dschnitkey/Fluorostat_Codes/fluorostat Illustrations/Images/Optics.jpg

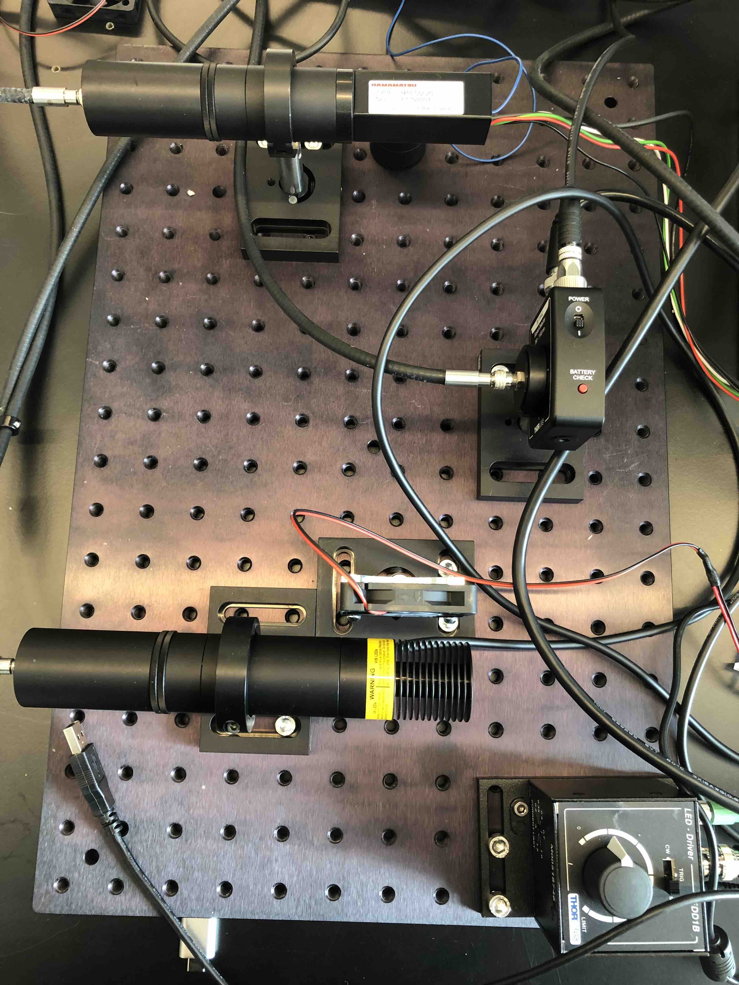
fluorostat Illustrations/Images/Optics.jpg
