dschnitkey/Fluorostat_Codes/fluorostat Illustrations/Images/fsat_evap - 1.jpg

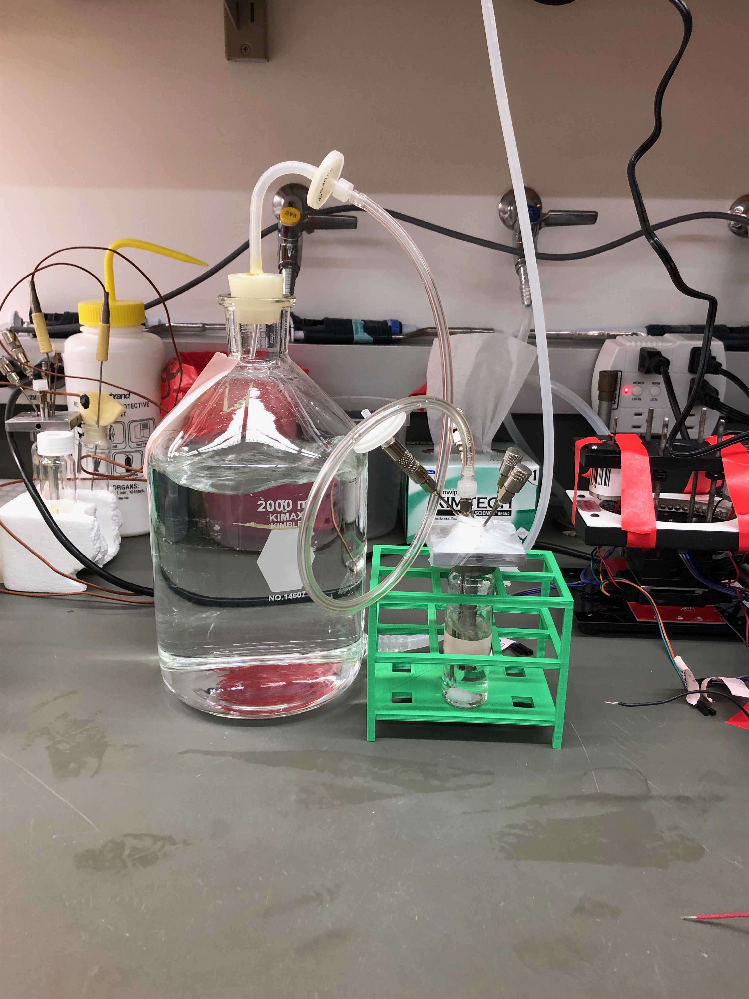
fluorostat Illustrations/Images/fsat_evap - 1.jpg
