dschnitkey/Fluorostat_Codes/Fluorostat Construction/spetra/Figures/All_Spectra_Coming_From_Sample.png

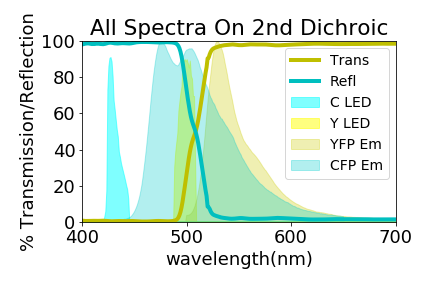
Fluorostat Construction/spetra/Figures/All_Spectra_Coming_From_Sample.png
