dschnitkey/Fluorostat_Codes/Fluorostat Construction/spetra/Figures/CFP Spectra and filters.png

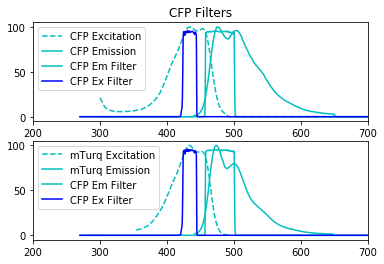
Fluorostat Construction/spetra/Figures/CFP Spectra and filters.png
