dschnitkey/Fluorostat_Codes/Fluorostat Construction/spetra/Figures/Cyan_LED_Spectrum.png

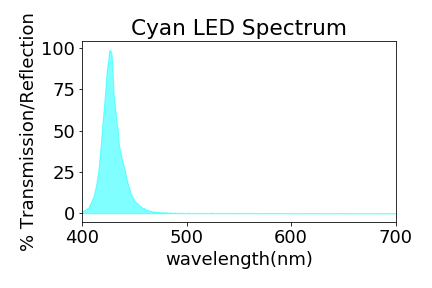
Fluorostat Construction/spetra/Figures/Cyan_LED_Spectrum.png
