dschnitkey/Fluorostat_Codes/Fluorostat Construction/spetra/Figures/Specific_Excitation.png

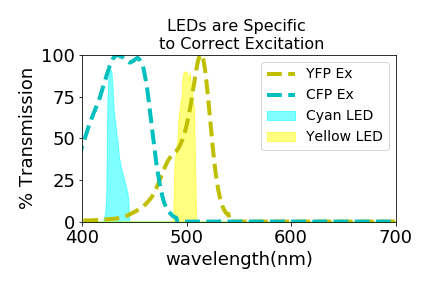
Fluorostat Construction/spetra/Figures/Specific_Excitation.png
