dschnitkey/Fluorostat_Codes/Fluorostat Construction/spetra/Figures/Spectra_Reaching_Sample.png

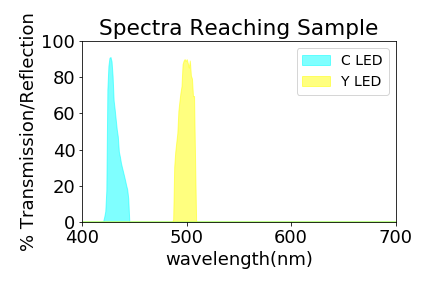
Fluorostat Construction/spetra/Figures/Spectra_Reaching_Sample.png
