dschnitkey/Fluorostat_Codes/Fluorostat Construction/spetra/Figures/spectraviewer_graph (3).png

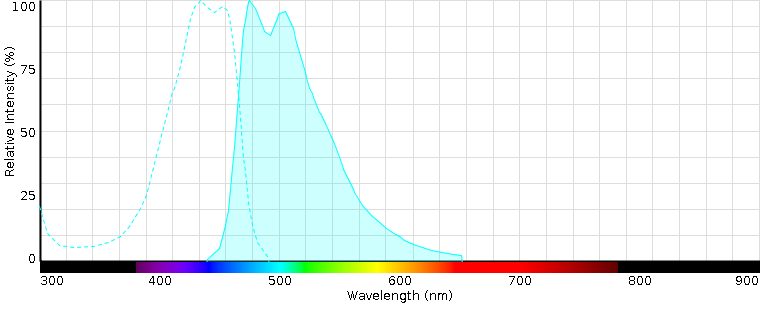
Fluorostat Construction/spetra/Figures/spectraviewer_graph (3).png
