dschnitkey/Fluorostat_Codes/Fluorostat Construction/spetra/Figures/Yellow_LED_Spectrum.png

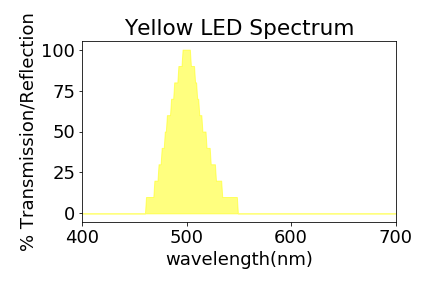
Fluorostat Construction/spetra/Figures/Yellow_LED_Spectrum.png
