dschnitkey/Fluorostat_Codes/Fluorostat Construction/spetra/Figures/YFP spectra and filters.png

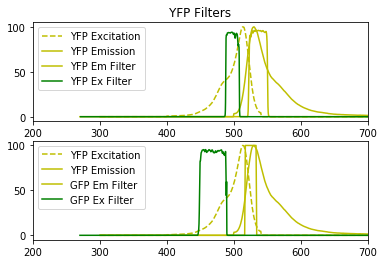
Fluorostat Construction/spetra/Figures/YFP spectra and filters.png
