dschnitkey/Fluorostat_Codes/fluorostat Illustrations/cyanomod_fluorostat_schematic.png

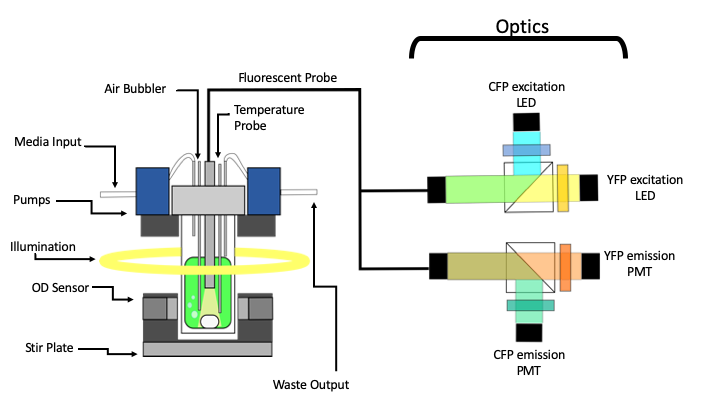
fluorostat Illustrations/cyanomod_fluorostat_schematic.png
