dschnitkey/Fluorostat_Codes/fluorostat Illustrations/fluorostat.png

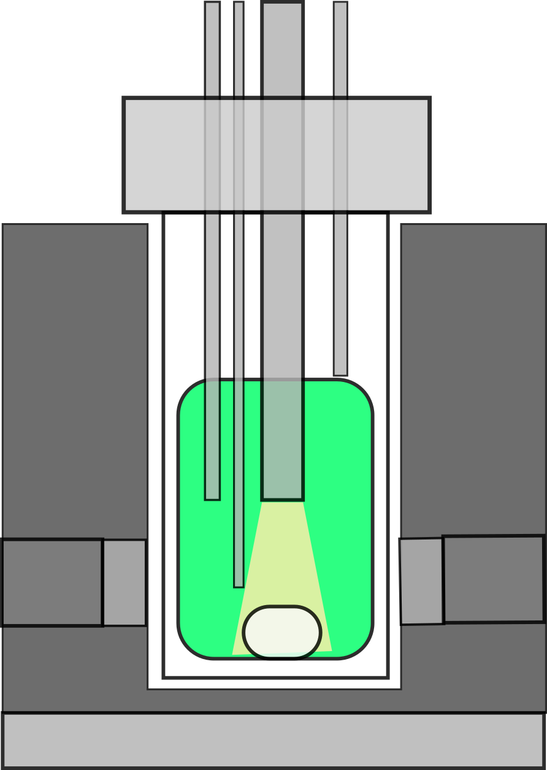
fluorostat Illustrations/fluorostat.png
