dschnitkey/Fluorostat_Codes/fluorostat Illustrations/fluorostat_aeration.png

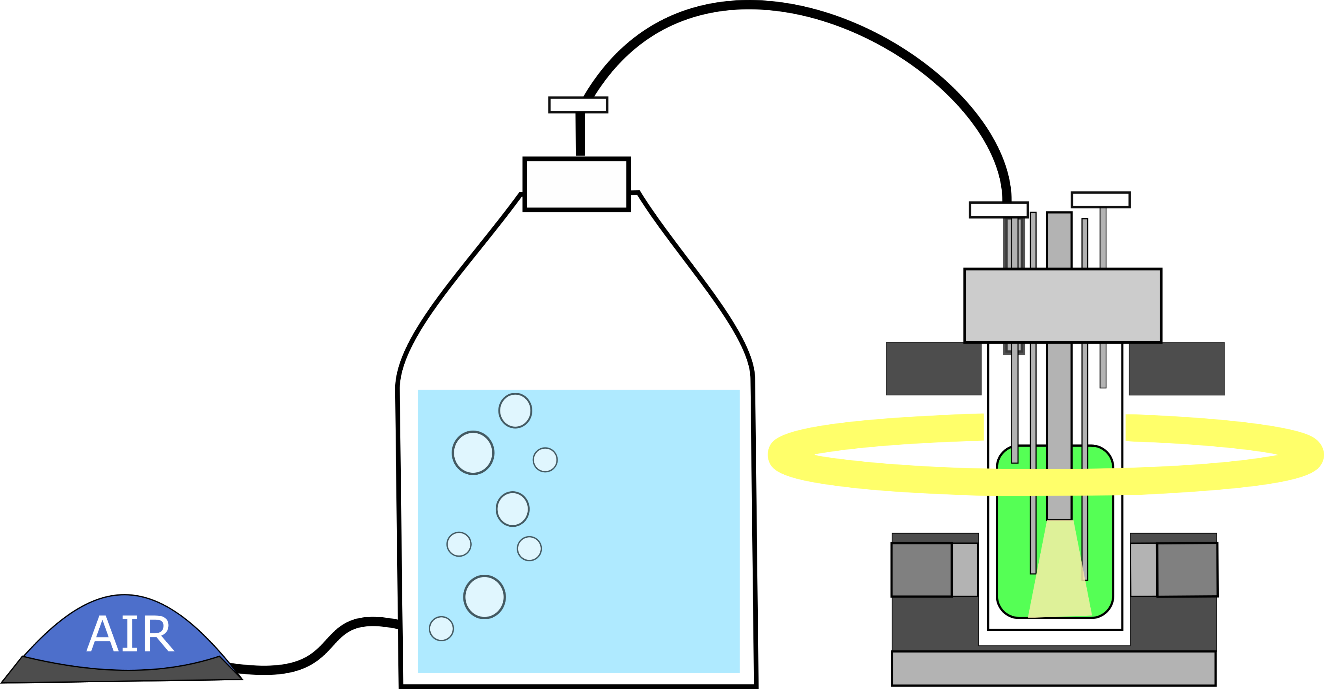
fluorostat Illustrations/fluorostat_aeration.png
