dschnitkey/Fluorostat_Codes/fluorostat Illustrations/fluorostat_base.jpg.png

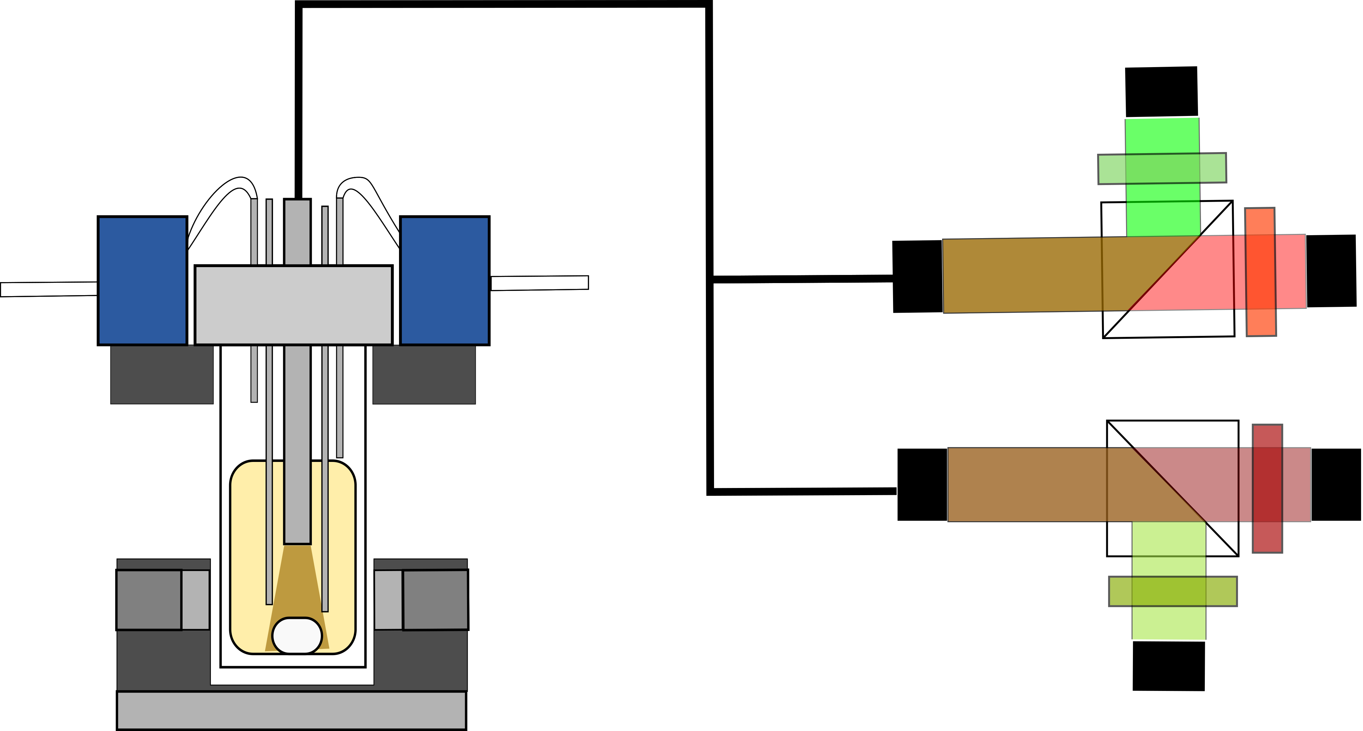
fluorostat Illustrations/fluorostat_base.jpg.png
