dschnitkey/Fluorostat_Codes/fluorostat Illustrations/fluorostat_foamcap_probe.png

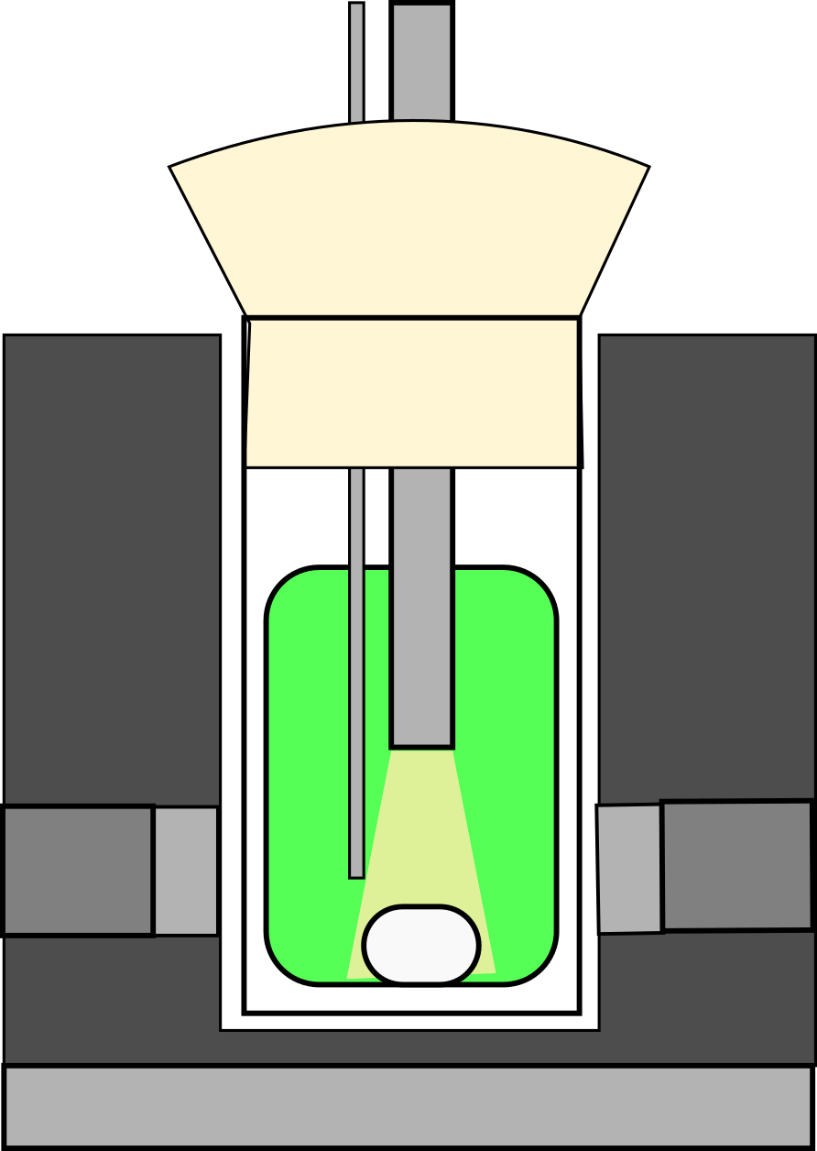
fluorostat Illustrations/fluorostat_foamcap_probe.png
