dschnitkey/Fluorostat_Codes/fluorostat Illustrations/fluorostat_foamcap_ringlight.png

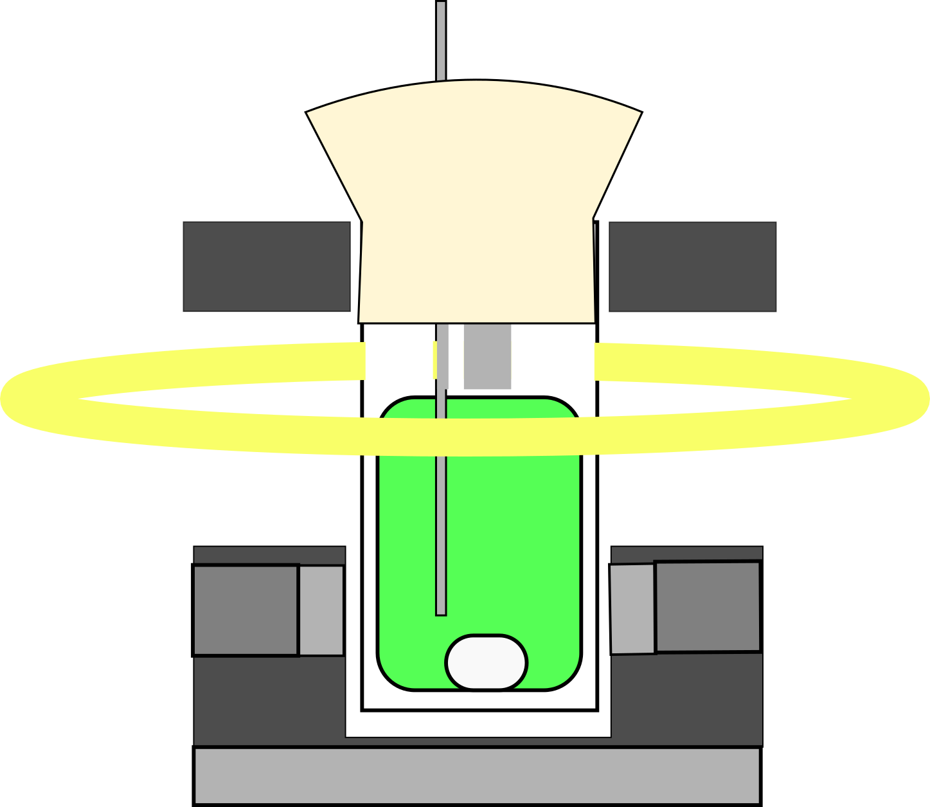
fluorostat Illustrations/fluorostat_foamcap_ringlight.png
