dschnitkey/Fluorostat_Codes/fluorostat Illustrations/fluorostatdead.png

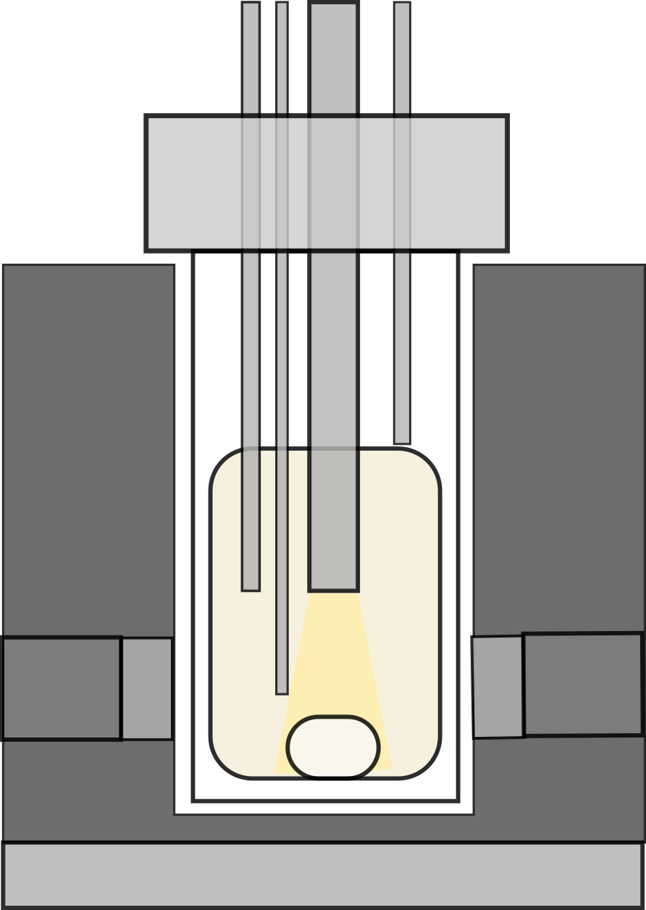
fluorostat Illustrations/fluorostatdead.png
