dschnitkey/Fluorostat_Codes/fluorostat Illustrations/fstat_air.png

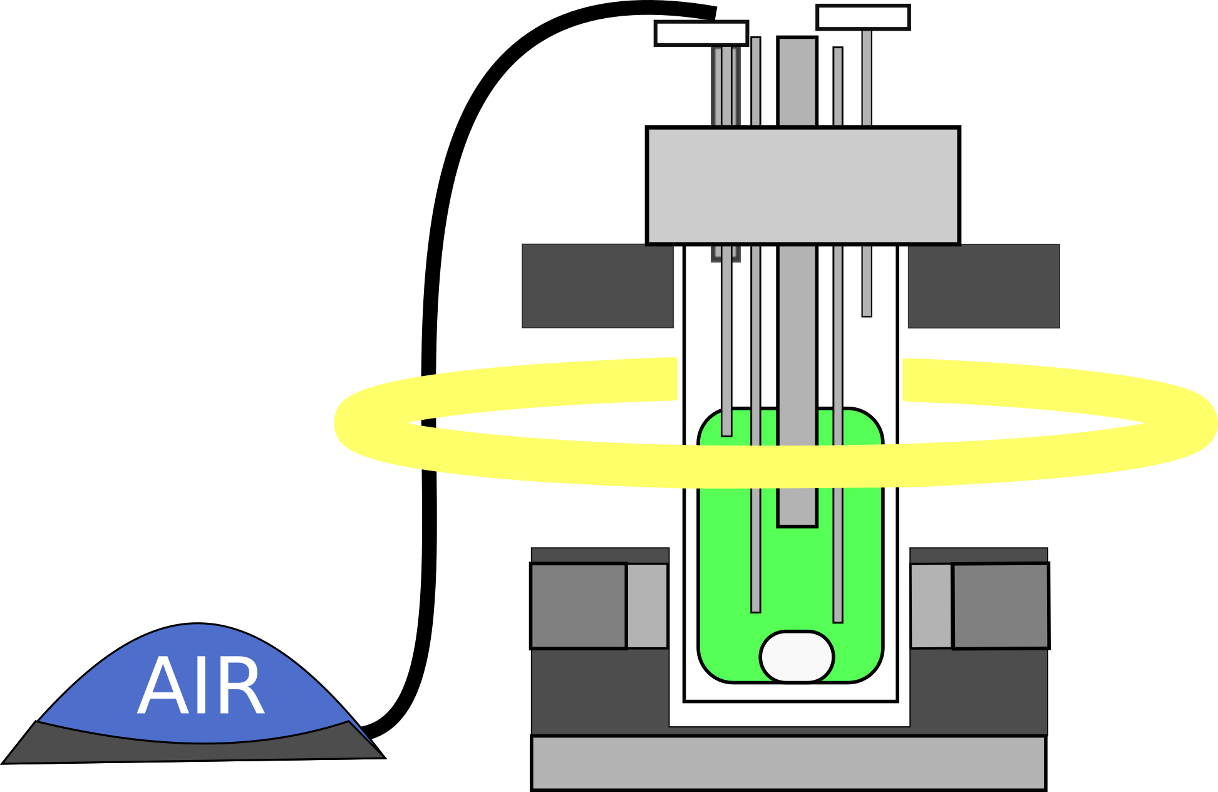
fluorostat Illustrations/fstat_air.png
