dschnitkey/Fluorostat_Codes/fluorostat Illustrations/Images/fsat_evap - 2.jpg

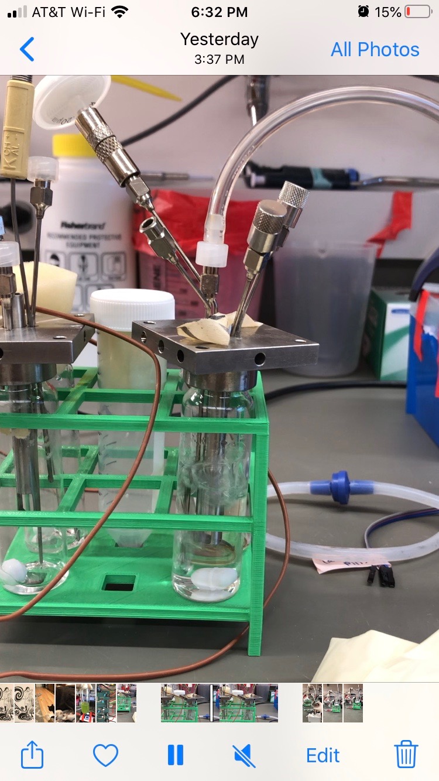
fluorostat Illustrations/Images/fsat_evap - 2.jpg
