dschnitkey/Fluorostat_Codes/fluorostat Illustrations/Images/fsat_evap - 3.jpg

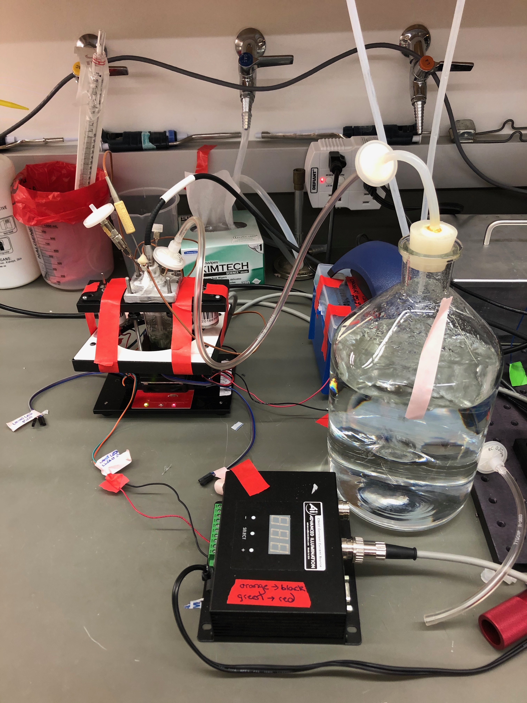
fluorostat Illustrations/Images/fsat_evap - 3.jpg
