dschnitkey/Fluorostat_Codes/fluorostat Illustrations/Images/Plugs.jpg

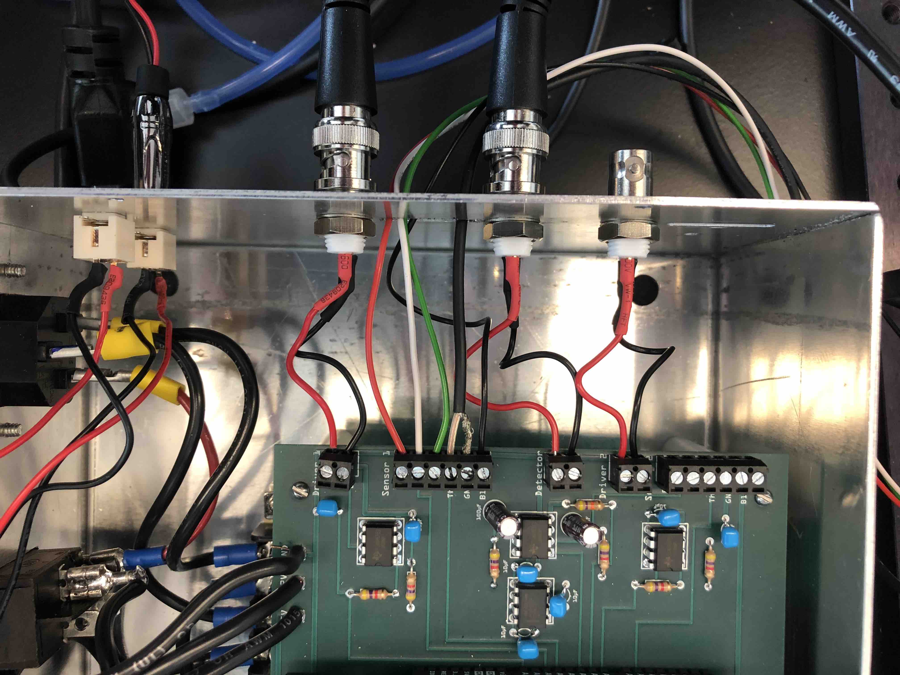
fluorostat Illustrations/Images/Plugs.jpg
