dschnitkey/Fluorostat_Codes/Fluorostat Construction/Fluorostat PCB Plans/partslist.xlsx

Amount | Part Type | Properties | Link | Unit Price | Total
2 | Diode | variant 1n4148; package diode-1n4148 | https://www.digikey.com/product-detail/en/on-semiconductor/1N914ATR/1N914ACT-ND/1626125
7 | 390Ω Resistor | bands 4; package THT; tolerance ±5%; pin spacing 400 mil; resistance 390Ω | https://www.digikey.com/product-detail/en/stackpole-electronics-inc/CF14JT390R/CF14JT390RCT-ND/1830340
7 | Ceramic Capacitor | package 200 mil [THT, multilayer]; capacitance 10µF; voltage 6.3V | https://www.digikey.com/product-detail/en/tdk-corporation/FK28X5R0J106MR000/445-FK28X5R0J106MR000-ND/2815522
3 | Generic female header - 1 pins | row single; hole size 2.2mm,0.508mm; form ♀ (female); pins 1; package THT; pin spacing 0.15in (3.81mm) | https://www.digikey.com/product-detail/en/sullins-connector-solutions/PPTC021LFBN-RC/S7000-ND/810142
6 | 4.7kΩ Resistor | bands 4; package THT; tolerance ±5%; pin spacing 400 mil; resistance 4.7kΩ | https://www.digikey.com/product-detail/en/stackpole-electronics-inc/CF14JT4K70/CF14JT4K70CT-ND/1830366 | 1.62/100 | 1.62
1 | 47kΩ Resistor | bands 4; package THT; tolerance ±5%; pin spacing 400 mil; resistance 47kΩ | https://www.digikey.com/product-detail/en/stackpole-electronics-inc/CFM14JT47K0/S47KQCT-ND/2617761 | .75/25 | 0.75
1 | Arduino Mega 2560 (Rev3) | type Arduino MEGA 2560 (Rev3) | https://www.digikey.com/products/en/development-boards-kits-programmers/evaluation-boards-embedded-mcu-dsp/786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 | 38.5 | 38.5
2 | Electrolytic Capacitor | package 100 mil [THT, electrolytic]; capacitance 100µF; voltage 6.3V | https://www.digikey.com/product-detail/en/panasonic-electronic-components/ECE-A0JKA101I/P19574CT-ND/6109472 | 1.53/10 | 1.53
4 | IC | hole size 1.0mm,0.508mm; pins 8; true; chip label IC; package DIP (Dual Inline) [THT]; pin spacing 300mil | https://www.digikey.com/product-detail/en/texas-instruments/LM358P/296-1395-5-ND/277042 | 6.45/25 | 6.45
3 | Screw terminal - 2 pins | hole size 1.1mm,0.508mm; pins 2; package THT; pin spacing 0.137in (3.5mm) | https://www.digikey.com/product-detail/en/phoenix-contact/1984617/277-1721-ND/950849 | 4.59/10 | 4.59
1 | Screw terminal - 4 pins | hole size 1.1mm,0.508mm; pins 4; package THT; pin spacing 0.137in (3.5mm) | https://www.digikey.com/product-detail/en/phoenix-contact/1985218/277-1624-ND/568661 | 5.55/10 | 5.55
15 | Generic female header - 1 pins | row single; hole size 1.0mm,0.4mm; form ♀ (female); pins 1; package THT; pin spacing 0.1in (2.54mm) | https://www.digikey.com/product-detail/en/sullins-connector-solutions/PPTC021LFBN-RC/S7000-ND/810142
1 | Generic female header - 2 pins | row single; hole size 1.0mm,0.4mm; form ♀ (female); pins 2; package THT; pin spacing 0.15in (3.81mm) | https://www.digikey.com/product-detail/en/sullins-connector-solutions/PPTC021LFBN-RC/S7000-ND/810142
1 | Generic female header - 6 pins | row single; hole size 1.0mm,0.4mm; form ♀ (female); pins 6; package THT; pin spacing 0.1in (2.54mm) | https://www.digikey.com/product-detail/en/sullins-connector-solutions/PPPC061LGBN-RC/S5481-ND/775939
6 | NPN-Transistor | type NPN (ECB); package TO92 [THT] | https://www.digikey.com/product-detail/en/on-semiconductor/2N5551BU/2N5551BU-ND/973957 | 2.28/10 | 2.28
2 | Screw terminal - 6 pins | hole size 1.1mm,0.508mm; pins 6; package THT; pin spacing 0.137in (3.5mm) | https://www.digikey.com/product-detail/en/on-shore-technology-inc/OSTTE060161/ED2639-ND/614588 | 10.68/10 | 10.68
 |  |  |  |  | 71.95
