dschnitkey/Fluorostat_Codes/Fluorostat Construction/Original Parts Lists/parts-list-fluorostat.xlsx

Sheet: Base Fluorostat
Part | Number | Source | Notes
For eGFP measurement
25mm dia gfp signal filter 525/15 | 1 | https://www.edmundoptics.com/p/525nm-cwl-25mm-dia-15nm-bandwidth-od-6-fluorescence-filter/28790/
25mm dia gfp excite filter 469/35 | 1 | https://www.thorlabs.com/thorproduct.cfm?partnumber=MF469-35
Excitation LED (for eGFP) | 1 | https://www.thorlabs.com/thorproduct.cfm?partnumber=M470L3
For mKATE measuremnt
25mm dia mkate signal filter 640/14 | 1 | https://www.edmundoptics.com/p/640nm-cwl-25mm-dia-14nm-bandwidth-od-6-fluorescence-filter/29399/
25mm dia mkate excite filter 586/20 | 1 | https://www.edmundoptics.com/p/586nm-cwl-25mm-dia-20nm-bandwidth-od-6-fluorescence-filter/27209/
Excitation LED (for mKate) | 1 | https://www.thorlabs.com/thorproduct.cfm?partnumber=M590L4
Sample Holder
photospectrometers | 2
Fan | 2 | https://www.digikey.ca/scripts/DkSearch/dksus.dll?Detail&itemSeq=243382999&uq=636457645476840310
Magnet | 4 | https://www.digikey.ca/product-detail/en/radial-magnet-inc/8195/469-1005-ND/555329
OD Amber LED | 4 | https://www.digikey.ca/products/en/optoelectronics/infrared-uv-visible-emitters/94?k=1125%201307%20ND
OD Sensor | 8 | https://www.adafruit.com/product/2748
heater | 2 | https://www.adafruit.com/product/1331
Pumps | 4 | https://www.adafruit.com/product/1150
Pump Tubings |  | https://www.coleparmer.ca/i/mn/0641163 | 3/32"ID x 5/32"OD | 25ml/19sec
Pump connectors | 4 | https://www.mcmaster.com/#5121k231/=1a3k74d | 1/8" to 3/32"
Media tubing |  | https://www.mcmaster.com/#5041k653/=1cqq3hs
Needle caps plastic |  | https://www.coleparmer.com/i/cole-parmer-animal-free-male-luer-lock-plug-pp-25-pk/3080030?pubid=SI | Male Luer Lock Plug
Needle caps stainless steel |  | https://www.mcmaster.com/#5194k37/=1cromkj
Thumb Nut | 4 | https://www.mcmaster.com/#93886a120/=1agy9nn
StirBar | 4 | https://www.uoftmedstore.com/item_detail.sz?id=553 | VWR, 1/2"x5/16"
2" 16G Needles | 20 | https://www.mcmaster.com/#6710a23/=1ccc100
4" 16G Needles for pump | 20 | https://www.mcmaster.com/#6710a43/=1ccc162
20G 4" Sampling needels | 20 | https://www.mcmaster.com/#6710a45/=1cron9z
2" 10G Needles
class bottles | 2
Optics:
HAMAMTSU MicroPMT | 1 | https://www.hamamatsu.com/us/en/product/type/H10722-20/index.html | A9865
PMT to cmount adaptor | 1 | https://www.hamamatsu.com/us/en/product/type/A9865/index.html | RP26
Fiber Optic Reflection/Backscatter Probe Bundles with Reference Leg | 1 | https://www.thorlabs.com/thorproduct.cfm?partnumber=RP26 | 470L3
Excitation LED (for eGFP) | 1 | https://www.thorlabs.com/thorproduct.cfm?partnumber=M470L3 | LEDD1B
Excitation LED Driver cube | 1 | https://www.thorlabs.com/thorproduct.cfm?partnumber=LEDD1B | KPS101
powersupply for LED driver cube | 1 | https://www.thorlabs.com/thorproduct.cfm?partnumber=KPS101 | ET36A2
DET36A2 excitation reference detector (https://www.thorlabs.com/images/xlarge/TTN134189-xl.jpg) | 1 | https://www.thorlabs.com/thorproduct.cfm?partnumber=DET36A2 | DET2B
DET Power Adapter & Power Supply Bundle | 1 | https://www.thorlabs.com/thorproduct.cfm?partnumber=DET2B | SM1SMA
SMA Fiber Adapter for DET36A2 | 1 | https://www.thorlabs.com/thorproduct.cfm?partnumber=SM1SMA | Ø1"
SM1RR Retaining Ring For stackable lens mount 0.08 thick | 4 | https://www.thorlabs.com/thorproduct.cfm?partnumber=SM1RR | ACL2520U-A
ACL2520U-A - Aspheric Condenser Lens, Ø25 mm, f=20.1 mm, NA=0.60 ARC: 350-700 nm | 4 | https://www.thorlabs.com/thorproduct.cfm?partnumber=ACL2520U-A | SM1M20
SM1 Lens Tube Without External Threads, 2" Long | 2 | https://www.thorlabs.com/thorproduct.cfm?partnumber=SM1M20 | SM1T2
SM1 Coupler, External Threads, 0.5" Long | 2 | https://www.thorlabs.com/thorproduct.cfm?partnumber=SM1T2 | SM1L20
SM1 Lens Tube, 2.00" Thread Depth | 1 | https://www.thorlabs.com/thorproduct.cfm?partnumber=SM1L20 | SM1L05 | ,
SM1 Lens Tube, 0.50" Thread Depth | 2 | https://www.thorlabs.com/thorproduct.cfm?partnumber=SM1L05 | SM1SMA
SMA Fiber Adapter Plate with External SM1 Threads | 2 | https://www.thorlabs.com/thorproduct.cfm?partnumber=SM1SMA | SM1L15
SM1 Lens Tube, 1.50" Thread Depth | 1 | https://www.thorlabs.com/thorproduct.cfm?partnumber=SM1L15 | BA2E
Flexure Clamping Base / Post Mount, Ø1/2" Double Bore, 2.00" x 3.00" x 0.48" | 6 | https://www.thorlabs.com/thorproduct.cfm?partnumber=BA2E | SM1TC
SM1TC - Ø1.20" Clamp for SM1 Lens Tubes and C-Mount Extension Tubes | 4 | https://www.thorlabs.com/thorproduct.cfm?partnumber=SM1TC | TR50/M
Ø12.7 mm Optical Post, SS, M4 Setscrew, M6 Tap, L = 50 mm | 6 | https://www.thorlabs.com/thorproduct.cfm?partnumber=TR50/M | SH6MS10
M6 x 1.0 Stainless Steel Cap Screw, 10 mm Long, Pack of 25 | 1 | https://www.thorlabs.com/thorproduct.cfm?partnumber=SH6MS10 | SM1RRC
SM1RRC - Extra-Thick SM1 (1.035"-40) Threaded Retaining Ring | 4 | https://www.thorlabs.com/thorproduct.cfm?partnumber=SM1RRC
Aluminium Breadboard, 300 mm x 450 mm x 12.7 mm, M6 taps | 1 | https://www.thorlabs.com/thorproduct.cfm?partnumber=MB3045/M

Sheet: Cyano Mods
Part | Number | Source | Part Number | Unit Price | Price
For YFP measurement
YFP Excitation Filter, CWL = 497 nm, BW = 16 nm | 1 | https://www.thorlabs.com/thorproduct.cfm?partnumber=MF497-16 | MF497-16 | $250.04 | $250.04
YFP Emission Filter, CWL = 535 nm BW = 22 nm | 1 | https://www.thorlabs.com/thorproduct.cfm?partnumber=MF535-22 | MF535-22 | $250.04 | $250.04
Excitation LED (for YFP) | 1 | https://www.thorlabs.com/thorproduct.cfm?partnumber=M505L4 | M505L4 | $287.86 | $287.86
 |  |  |  |  |  | Total Price
For CFP measurement |  |  |  |  |  | 2854.55
CFP Emission Filter, CWL = 479 nm, BW = 40 nm | 1 | https://www.thorlabs.com/thorproduct.cfm?partnumber=MF479-40 | MF479-40 | $250.04 | $250.04
CFP Excitation Filter, CWL = 434 nm, BW = 17 nm | 1 | https://www.thorlabs.com/thorproduct.cfm?partnumber=MF434-17 | MF434-17 | $250.04 | $250.04
Excitation LED (for CFP) | 1 | https://www.thorlabs.com/thorproduct.cfm?partnumber=M430L4 | M430L4 | $169.95 | $169.95
Dichroic
5 mm x 36 mm Longpass Dichroic Mirror, 505 nm | 1 | https://www.thorlabs.com/thorproduct.cfm?partnumber=DMLP505R | DMLP505R | $246.89 | $246.89
DMLP490R - 25 mm x 36 mm Longpass Dichroic Mirror, 490 nm Cut-On | 1 | https://www.thorlabs.com/thorproduct.cfm?partnumber=DMLP490R | DMLP490R | $246.89 | $246.89
Dichroic filter mount, 30 mm cage system | 2 | https://www.thorlabs.com/thorproduct.cfm?partnumber=CM1-DCH | CM1-DCH | $170.20 | $340.40
 | 2 | https://www.thorlabs.com/thorproduct.cfm?partnumber=SM1L03 | SM1L03 | $12.16 | $24.32
OD 700 parts
720 nm LED | 1 | https://www.digikey.com/products/en?WT.z_cid=sp_1125_buynow&site=us&mpart=MT5720-IR | 1125-1411-ND | $7.20 | $7.20
730 nm LED can top (Backup Option) | 0 | https://www.digikey.ca/product-detail/en/advanced-photonix/LS-0730-015/LS-0730-015-ND/9666161 | LS-0730-015-ND | $12.50 | $0.00
Illumination
Warm White LED | 1 | https://www.ledsupply.com/leds/5mm-led-warm-white-50-degree-viewing-angle | L1-0-WW5TH50-1 | $0.49 | $0.49
Circular Illumination Ring
Two Color Cage Set Up
Ø1" Retaining Rings and Spanner Wrenches | 1 | https://www.thorlabs.com/thorproduct.cfm?partnumber=SPW602 | SPW602 | $27.55 | $27.55
Cage Assembly Rod, 1/4" Long, Ø6 mm | 64 | https://www.thorlabs.com/thorproduct.cfm?partnumber=ER025 | ER025 | $5.05 | $323.20
Aspheric Condenser Lens | 6 | https://www.thorlabs.com/thorproduct.cfm?partnumber=ACL2520U-A | ACL2520U-A | $29.94 | $179.64

Sheet: Sheet1
Item # | Infoa | Nominal | Housing | LED Output Power | Bandwidth | Irradiance | Max Current | Forward | Viewing Angle | Recommended | Fluorophore
 |  | Wavelengthb,c | Typed | (Min / Typ.)b,e | (FWHM) | (Typ.)f | (CW) | Voltage (Typ.) | (Full Angle at Half Max) | Driver
M590L4 |  | 590 nm (Amber) |  | 230 mW / 300 mW | 15 nm | 6.0 µW/mm2 | 1000 mA | 2.5 V | 80° | DC2200, LEDD1B, DC4100h, or DC4104h | RFP
M470L4 |  | 470 nm (Blue) |  | 760 mW / 965 mW | 26 nm | 19.9 µW/mm2 | 1000 mA | 3.2 V | 80° | DC2200, LEDD1B, DC4100h, or DC4104h | GFP
M430L4 |  | 430 nm (Violet) |  | 490 mW / 600 mW | 15 nm | 35.3 µW/mm2 | 500 mA | 3.8 V | 22° | DC2200, LEDD1B, DC4100h, or DC4104h | CFP
M505L4 |  | 505 nm (Cyan) |  | 400 mW / 520 mW | 37 nm | 5.94 µW/mm2 | 1000 mA | 3.5 V | 130° | DC2200, LEDD1B, DC4100h, or DC4104h | YFP
