dschnitkey/Fluorostat_Codes/Fluorostat Construction/Original Parts Lists/CFP_YFP_Optics.xlsx

Part | Number | Source | Part Number | Unit Price | Price
For YFP measurement
YFP Excitation Filter, CWL = 497 nm, BW = 16 nm | 1 | https://www.thorlabs.com/thorproduct.cfm?partnumber=MF497-16 | MF497-16 | $250.04 | $250.04
YFP Emission Filter, CWL = 535 nm BW = 22 nm | 1 | https://www.thorlabs.com/thorproduct.cfm?partnumber=MF535-22 | MF535-22 | $250.04 | $250.04
Excitation LED (for YFP) | 1 | https://www.thorlabs.com/thorproduct.cfm?partnumber=M505L4 | M505L4 | $287.86 | $287.86
 |  |  |  |  |  | Total Price
For CFP measurement |  |  |  |  |  | 2747.48
CFP Emission Filter, CWL = 479 nm, BW = 40 nm | 1 | https://www.thorlabs.com/thorproduct.cfm?partnumber=MF479-40 | MF479-40 | $250.04 | $250.04
CFP Excitation Filter, CWL = 434 nm, BW = 17 nm | 1 | https://www.thorlabs.com/thorproduct.cfm?partnumber=MF434-17 | MF434-17 | $250.04 | $250.04
Excitation LED (for CFP) | 1 | https://www.thorlabs.com/thorproduct.cfm?partnumber=M430L4 | M430L4 | $169.95 | $169.95
Dichroic
5 mm x 36 mm Longpass Dichroic Mirror, 505 nm | 1 | https://www.thorlabs.com/thorproduct.cfm?partnumber=DMLP505R | DMLP505R | $246.89 | $246.89
DMLP490R - 25 mm x 36 mm Longpass Dichroic Mirror, 490 nm Cut-On | 1 | https://www.thorlabs.com/thorproduct.cfm?partnumber=DMLP490R | DMLP490R | $246.89 | $246.89
Dichroic filter mount, 30 mm cage system | 2 | https://www.thorlabs.com/thorproduct.cfm?partnumber=CM1-DCH | CM1-DCH | $170.20 | $340.40
Condensor Lenses
Aspheric Condenser Lens | 2 | https://www.thorlabs.com/thorproduct.cfm?partnumber=ACL2520U-A | ACL2520U-A | $29.98 | $59.96
Mounts and Holders- additional
SM1RR Retaining Ring For stackable lens mount 0.08 thick | 4 | https://www.thorlabs.com/thorproduct.cfm?partnumber=SM1RR | SM1RR | $4.50 | $18.00
SM1 Lens Tube Without External Threads, 2" Long | 1 | https://www.thorlabs.com/thorproduct.cfm?partnumber=SM1M20 | SM1M20 | $16.71 | $16.71
SM1 Coupler, External Threads, 0.5" Long | 1 | https://www.thorlabs.com/thorproduct.cfm?partnumber=SM1T2 | SM1T2 | $20.91 | $20.91
SM1 Lens Tube, 0.50" Thread Depth | 1 | https://www.thorlabs.com/thorproduct.cfm?partnumber=SM1L05 | SM1L05 | $12.59 | $12.59
SMA Fiber Adapter Plate with External SM1 Threads | 1 | https://www.thorlabs.com/thorproduct.cfm?partnumber=SM1SMA | SM1SMA | $30.47 | $30.47
Flexure Clamping Base / Post Mount, Ø1/2" Double Bore, 2.00" x 3.00" x 0.48" | 3 | https://www.thorlabs.com/thorproduct.cfm?partnumber=BA2E | BA2E | $32.62 | $97.86
Ø12.7 mm Optical Post, SS, M4 Setscrew, M6 Tap, L = 50 mm | 3 | https://www.thorlabs.com/thorproduct.cfm?partnumber=TR50/M | TR50/M | $5.19 | $15.57
SM1RRC - Extra-Thick SM1 (1.035"-40) Threaded Retaining Ring | 2 | https://www.thorlabs.com/thorproduct.cfm?partnumber=SM1RRC | SM1RRC | $10.83 | $21.66
Cage Assembly Rod, 1/4" Long, Ø6 mm | 32 | https://www.thorlabs.com/thorproduct.cfm?partnumber=ER025 | ER025 | $5.05 | $161.60
