dschnitkey/Fluorostat_Codes/Fluorostat Construction/Machined Parts/CAD Drawings/3D Printatbles STL/motorholder_prethreading_v2.stl

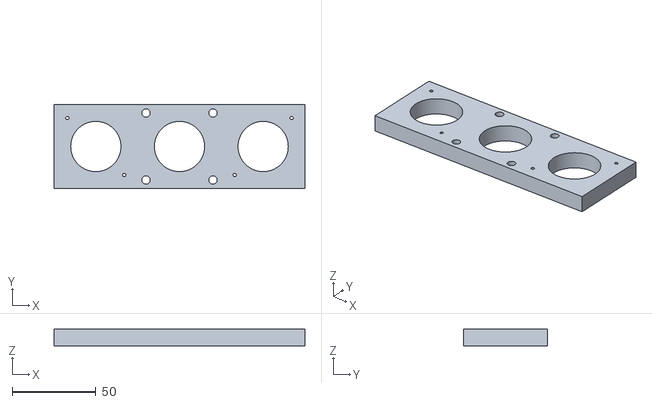
[picture p22: CAD file, 2021-06-05]
Fluorostat Construction/Machined Parts/CAD Drawings/3D Printatbles STL/motorholder_prethreading_v2.stl
150.0 x 50.0 x 10.0
