dschnitkey/Fluorostat_Codes/Fluorostat Construction/Machined Parts/CAD Drawings/CAD Files/light support.FCStd

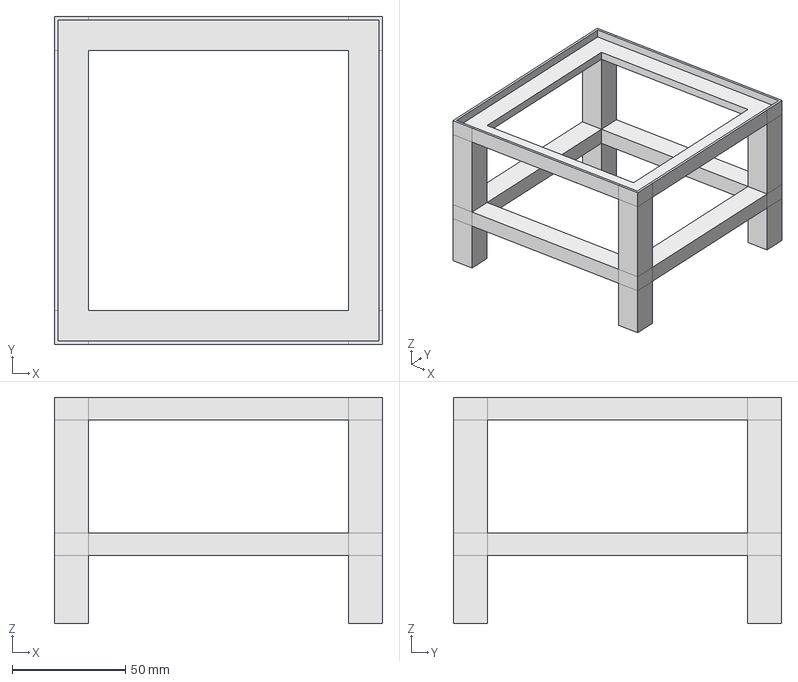
[picture p23: CAD file, 2021-06-05]
Fluorostat Construction/Machined Parts/CAD Drawings/CAD Files/light support.FCStd
145.0 x 145.0 x 100.0 mm
