dschnitkey/Fluorostat_Codes/Fluorostat Construction/Machined Parts/CAD Drawings/CAD Files/light support v3.FCStd

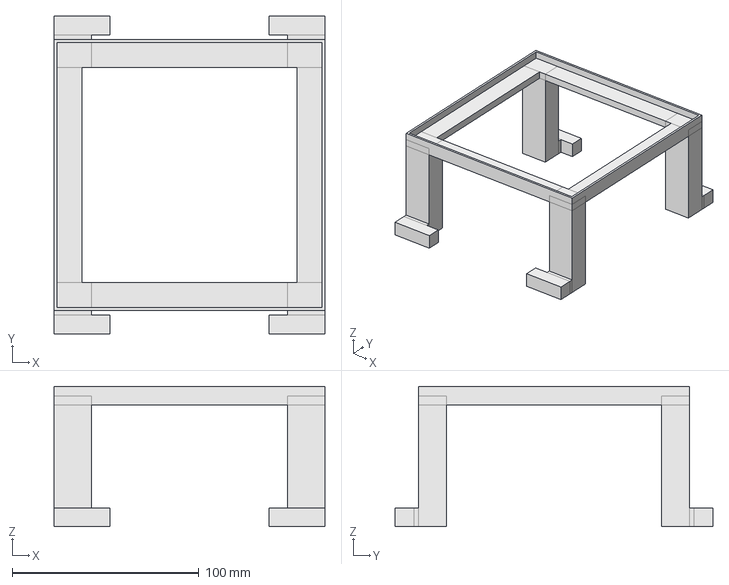
[picture p24: CAD file, 2021-06-05]
Fluorostat Construction/Machined Parts/CAD Drawings/CAD Files/light support v3.FCStd
145.0 x 170.0 x 75.0 mm
