dschnitkey/Fluorostat_Codes/Fluorostat Construction/Machined Parts/CAD Drawings/3D Printatbles STL/OD_holder_v1.stl

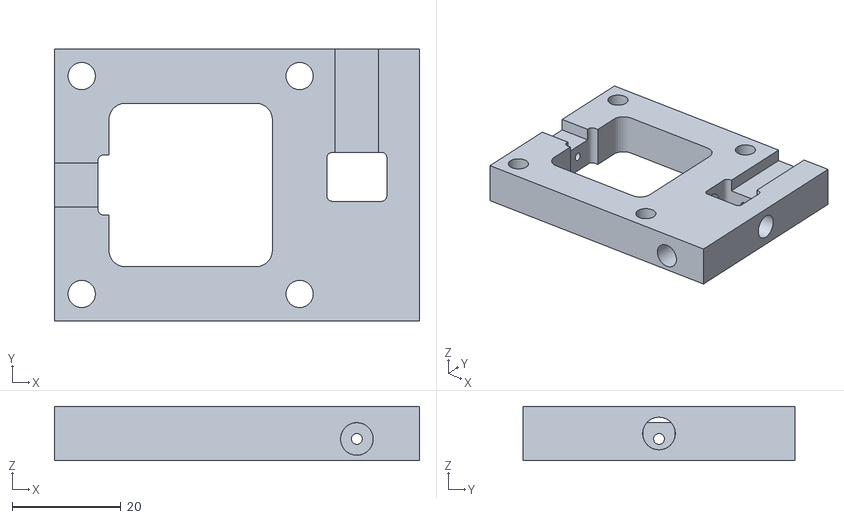
[picture p25: CAD file, 2021-06-05]
Fluorostat Construction/Machined Parts/CAD Drawings/3D Printatbles STL/OD_holder_v1.stl
67.0 x 50.0 x 10.0
