dschnitkey/Fluorostat_Codes/Fluorostat Construction/Machined Parts/CAD Drawings/3D Printatbles STL/lightsupporthalf.stl

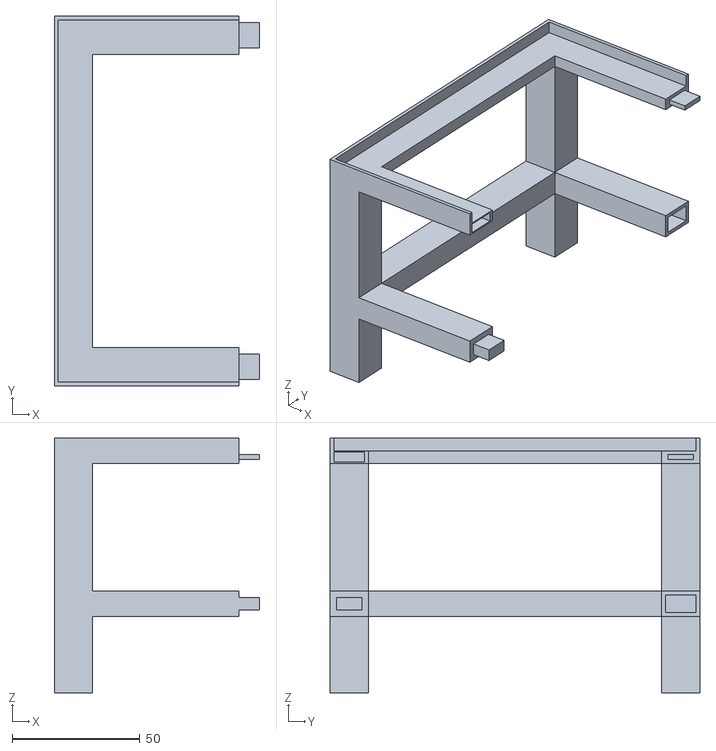
[picture p26: CAD file, 2021-06-05]
Fluorostat Construction/Machined Parts/CAD Drawings/3D Printatbles STL/lightsupporthalf.stl
80.5 x 145.0 x 100.0
