dschnitkey/Fluorostat_Codes/Fluorostat Construction/Machined Parts/CAD Drawings/CAD Files/sample holder base.FCStd

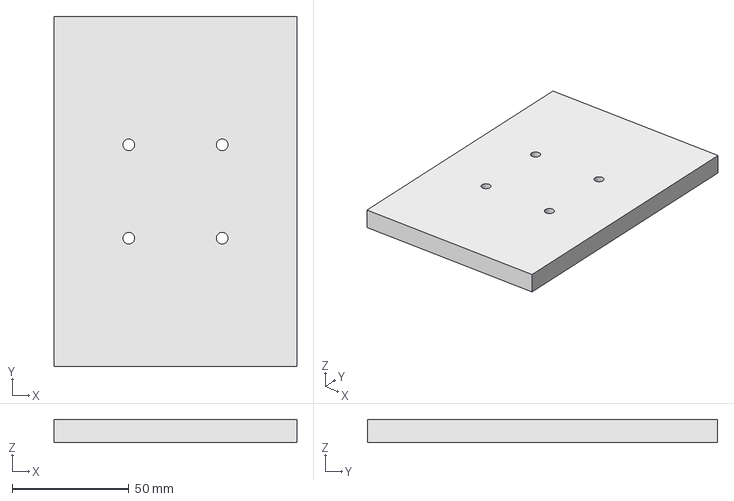
[picture p27: CAD file, 2021-06-05]
Fluorostat Construction/Machined Parts/CAD Drawings/CAD Files/sample holder base.FCStd
104.0 x 150.0 x 10.0 mm
