dschnitkey/Fluorostat_Codes/Fluorostat Construction/Machined Parts/CAD Drawings/3D Printatbles STL/8:32 thread.stl

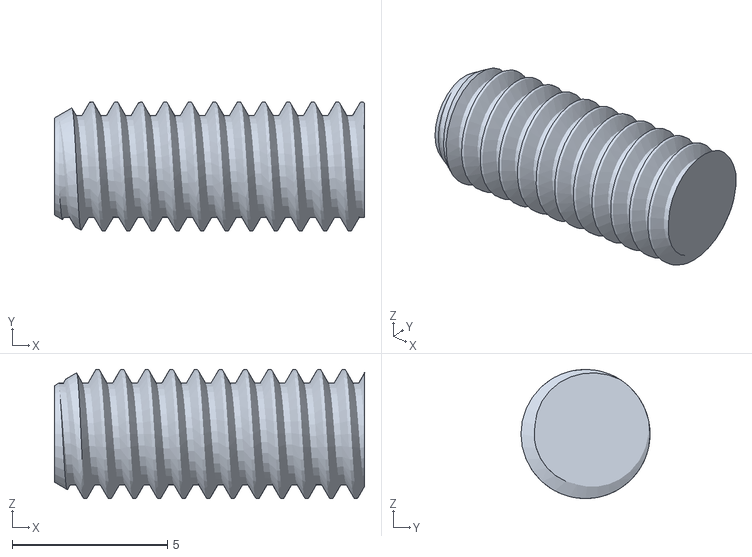
[picture p28: CAD file, 2021-06-05]
Fluorostat Construction/Machined Parts/CAD Drawings/3D Printatbles STL/8:32 thread.stl
10.0 x 4.17 x 4.17
