dschnitkey/Fluorostat_Codes/Fluorostat Construction/Machined Parts/CAD Drawings/CAD Files/motorholder_prethreading-Cut004.dxf

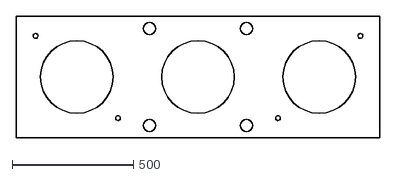
[picture p29: CAD file, 2021-06-05]
Fluorostat Construction/Machined Parts/CAD Drawings/CAD Files/motorholder_prethreading-Cut004.dxf
1500.0 x 500.0
