dschnitkey/Fluorostat_Codes/Fluorostat Construction/Machined Parts/CAD Drawings/3D Printatbles STL/motorholder_prethreading_schematic.stl

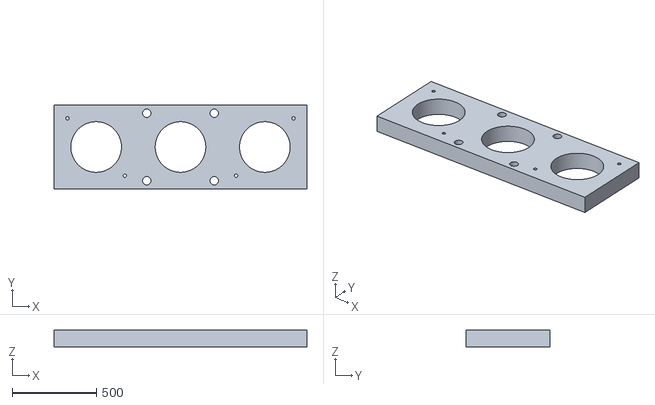
[picture p30: CAD file, 2021-06-05]
Fluorostat Construction/Machined Parts/CAD Drawings/3D Printatbles STL/motorholder_prethreading_schematic.stl
1500.0 x 500.0 x 100.0
