dschnitkey/Fluorostat_Codes/Fluorostat Construction/Machined Parts/CAD Drawings/CAD Files/OD holder.FCStd

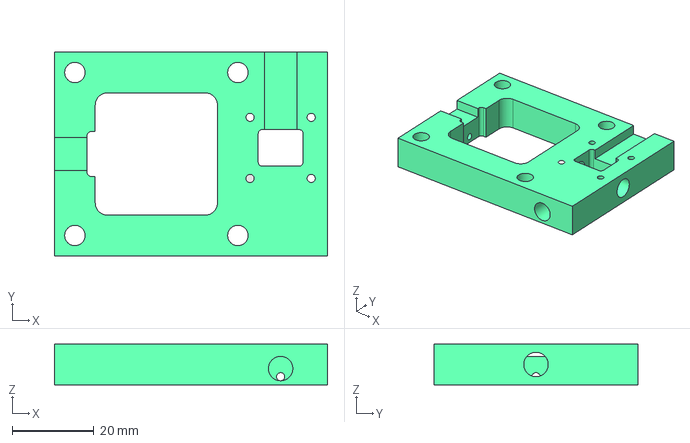
[picture p31: CAD file, 2021-06-05]
Fluorostat Construction/Machined Parts/CAD Drawings/CAD Files/OD holder.FCStd
67.0 x 50.0 x 10.0 mm
