dschnitkey/Fluorostat_Codes/(list of files, cad)

Other CAD files:
Fluorostat Construction/Machined Parts/CAD Drawings/3D Printatbles STL/lightsupport_v2.FCStd
Fluorostat Construction/Machined Parts/CAD Drawings/3D Printatbles STL/light support v3.stl
Fluorostat Construction/Machined Parts/CAD Drawings/CAD Files/motorholder_prethreading.FCStd
Fluorostat Construction/Machined Parts/CAD Drawings/CAD Files/light support half.FCStd
Fluorostat Construction/Machined Parts/CAD Drawings/3D Printatbles STL/lightsupport.stl
Fluorostat Construction/Machined Parts/CAD Drawings/3D Printatbles STL/OD holder_v2.stl
Fluorostat Construction/Machined Parts/CAD Drawings/3D Printatbles STL/sample holder base.stl
Fluorostat Construction/Machined Parts/CAD Drawings/3D Printatbles STL/lightsupportv2.stl
Fluorostat Construction/Machined Parts/CAD Drawings/CAD Files/OD holder.dxf
Fluorostat Construction/Machined Parts/CAD Drawings/CAD Files/light support v2.FCStd
Fluorostat Construction/Machined Parts/CAD Drawings/CAD Files/sample holder base.stl
