dschnitkey/Fluorostat_Codes/Fluorostat Construction/spetra/Figures/LaserDiagram_CFP_YFP.pdf

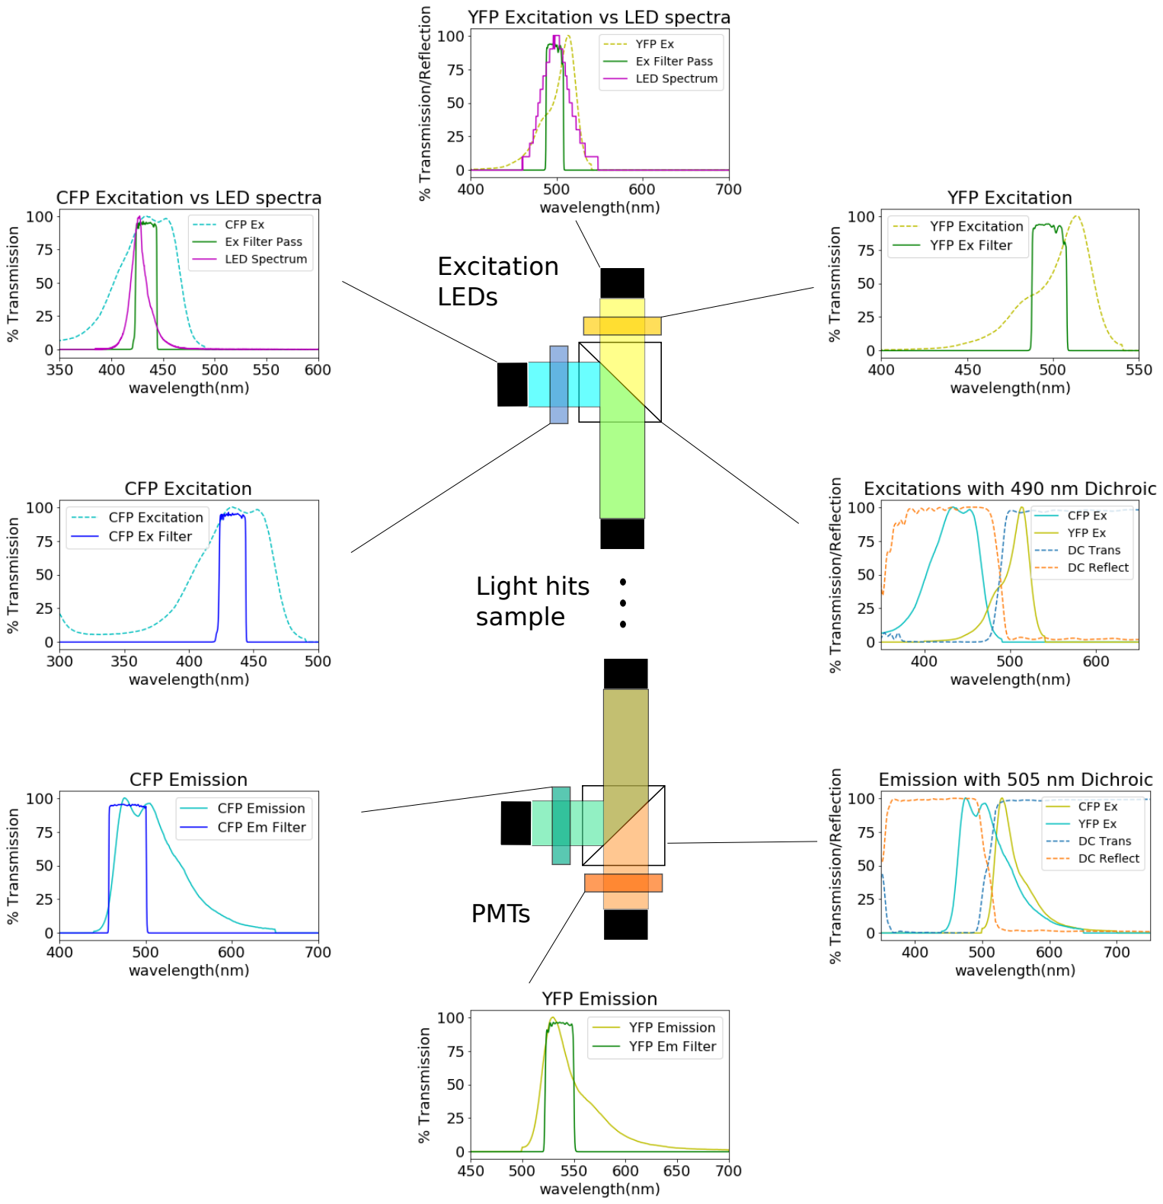
[picture p58: page 1]

Excitation
LEDs

PMTs

Light hits
sample
