dschnitkey/Fluorostat_Codes/Fluorostat Construction/spetra/Figures/LaserDiagram_CFP_YFP_v2.pdf

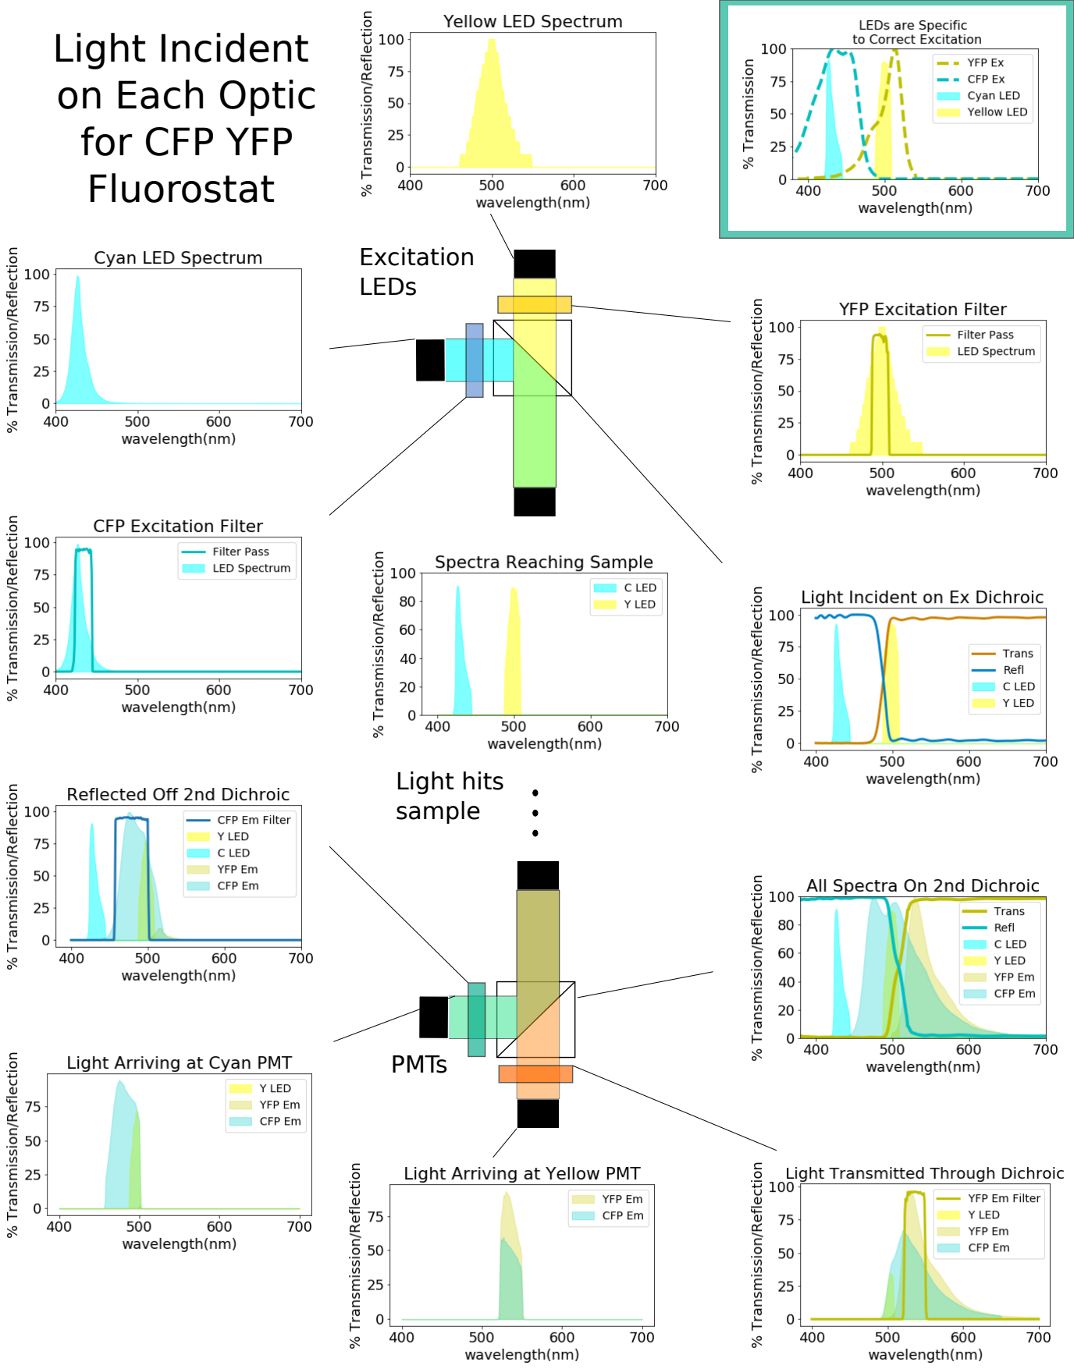
[picture p59: page 1]

Excitation
LEDs

PMTs

Light hits
sample

Light Incident
on Each Optic
for CFP YFP
Fluorostat
