dschnitkey/Fluorostat_Codes/Fluorostat Construction/Fluorostat PCB Plans/Motherboard_check.xlsx

Voltage Difference for Each Part | OD On | Heater On | Stir On | Level LED | Pumps In | Pump Out | OD Sensor | Level LED Sensor | OD LED Ref | Level Sensor | All Off | Works as it should?
OD | 5 | 0 | 0 | 0 | 5 | 5 | 0 | 0 | 0.2 | 0.2 | 0.2 | N
Heater | 0 | 0 | 0 | 0 | 0 | 0 | 0 | 0 | 0 | 0 | 0 | N
Stir | 0 | 0 | 12 | 0 | 0 | 0 | 0 | 0 | 0 | 0 | 0 | Y | on when shouldn't be
Level LED | 0 | 0 | 0 | 5 | 0 | 0 | 0 | 0 | 0 | 0 | 0 | Y | not on when should be
Pump in | 12 | 7 | 7 | 7 | 12 | 12 | 7 | 7 | 7 | 7 | 7 | N | on when should be
Pump out | 12 | 7 | 7 | 7 | 12 | 12 | 7 | 7 | 7 | 7 | 7 | N | off when should be
OD Sensor |  |  |  |  |  |  |  |  |  |  |  | Unsure | unsure
Level LED Sensor Ref |  |  |  |  |  |  |  |  |  |  |  | Unsure
OD LED ref |  |  |  |  |  |  |  |  |  |  |  | Unsure
Level Sensor |  |  |  |  |  |  |  |  |  |  |  | Unsure
