dschnitkey/Fluorostat_Codes/Fluorostat Construction/spetra/Figures/CFP_Emission.png

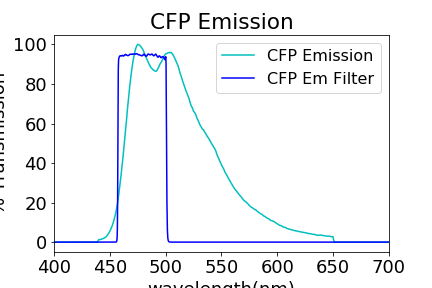
Fluorostat Construction/spetra/Figures/CFP_Emission.png
