dschnitkey/Fluorostat_Codes/Fluorostat Construction/spetra/Figures/CFP_Excitation.png

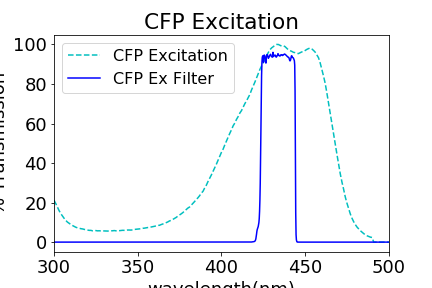
Fluorostat Construction/spetra/Figures/CFP_Excitation.png
