dschnitkey/Fluorostat_Codes/Fluorostat Construction/spetra/Figures/CFP_Excitation_Filter.png

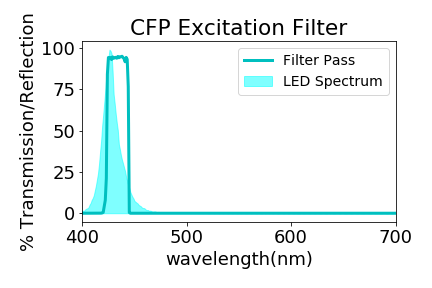
Fluorostat Construction/spetra/Figures/CFP_Excitation_Filter.png
