dschnitkey/Fluorostat_Codes/Fluorostat Construction/spetra/Figures/CFP_LED.png

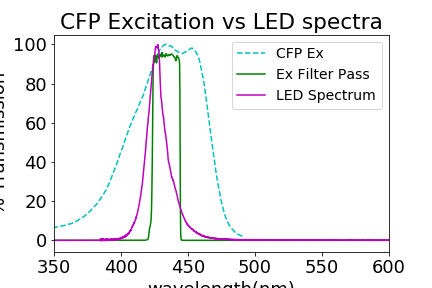
Fluorostat Construction/spetra/Figures/CFP_LED.png
