dschnitkey/Fluorostat_Codes/Fluorostat Construction/spetra/Figures/Dichroic_490.png

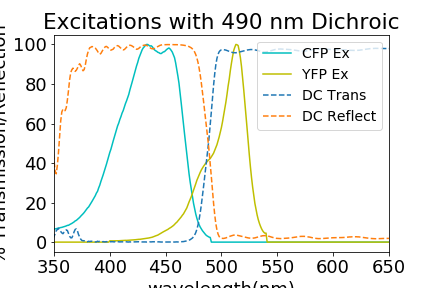
Fluorostat Construction/spetra/Figures/Dichroic_490.png
