dschnitkey/Fluorostat_Codes/Fluorostat Construction/spetra/Figures/Dichroic_505.png

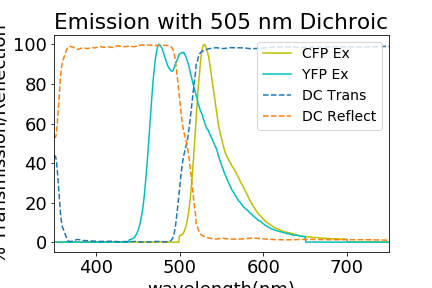
Fluorostat Construction/spetra/Figures/Dichroic_505.png
