dschnitkey/Fluorostat_Codes/Fluorostat Construction/spetra/Figures/dichroic_em.png

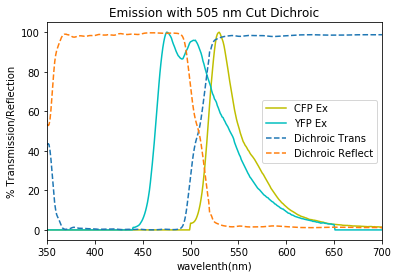
Fluorostat Construction/spetra/Figures/dichroic_em.png
