dschnitkey/Fluorostat_Codes/Fluorostat Construction/spetra/Figures/Hits_Cyan_PMT.png

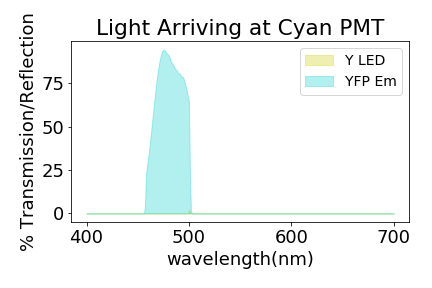
Fluorostat Construction/spetra/Figures/Hits_Cyan_PMT.png
