dschnitkey/Fluorostat_Codes/Fluorostat Construction/spetra/Figures/Hits_Yellow_PMT.png

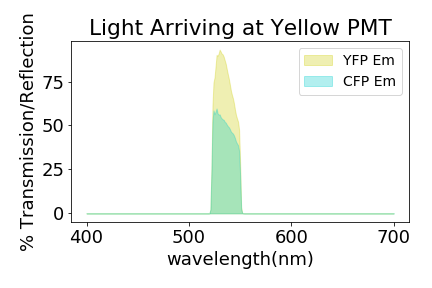
Fluorostat Construction/spetra/Figures/Hits_Yellow_PMT.png
