dschnitkey/Fluorostat_Codes/Fluorostat Construction/spetra/Figures/Laser and filter alignment.png

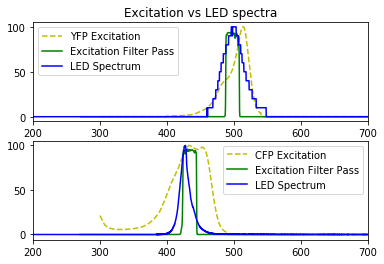
Fluorostat Construction/spetra/Figures/Laser and filter alignment.png
