dschnitkey/Fluorostat_Codes/Fluorostat Construction/spetra/Figures/Light_Incident_on_Ex_Dichroic.png

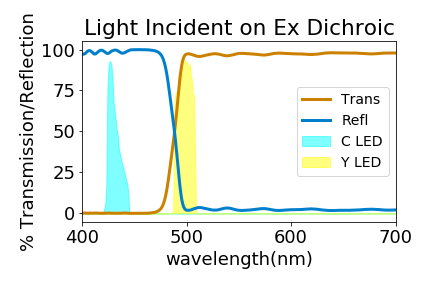
Fluorostat Construction/spetra/Figures/Light_Incident_on_Ex_Dichroic.png
