dschnitkey/Fluorostat_Codes/Fluorostat Construction/spetra/Figures/Ref_2_Dichroic.png

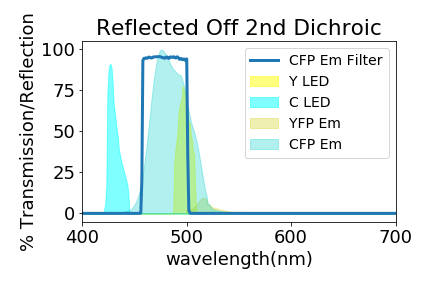
Fluorostat Construction/spetra/Figures/Ref_2_Dichroic.png
