dschnitkey/Fluorostat_Codes/Fluorostat Construction/spetra/Figures/Trans_2_Dichroic.png

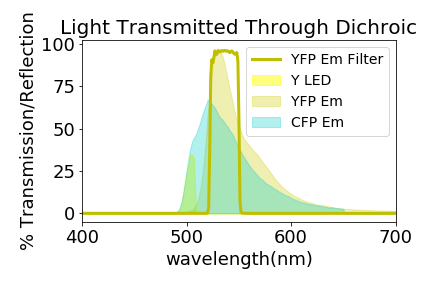
Fluorostat Construction/spetra/Figures/Trans_2_Dichroic.png
