dschnitkey/Fluorostat_Codes/Fluorostat Construction/spetra/Figures/YFP_Emission.png

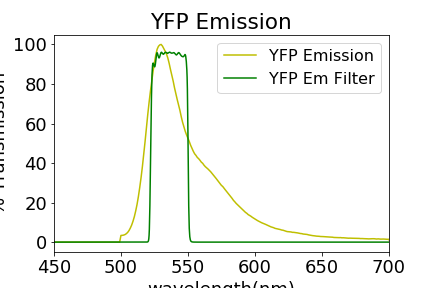
Fluorostat Construction/spetra/Figures/YFP_Emission.png
