dschnitkey/Fluorostat_Codes/Fluorostat Construction/spetra/Figures/YFP_Excitation.png

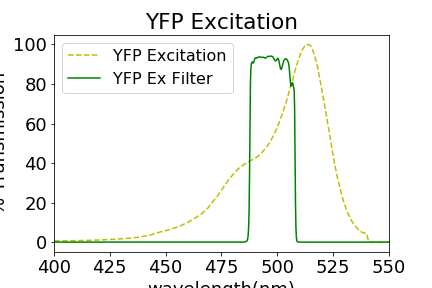
Fluorostat Construction/spetra/Figures/YFP_Excitation.png
