dschnitkey/Fluorostat_Codes/Fluorostat Construction/spetra/Figures/YFP_Excitation_Filter.png

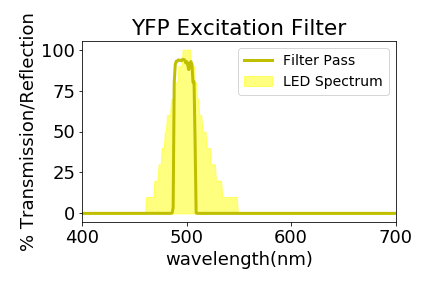
Fluorostat Construction/spetra/Figures/YFP_Excitation_Filter.png
