dschnitkey/Fluorostat_Codes/Fluorostat Construction/spetra/Figures/YFP_LED.png

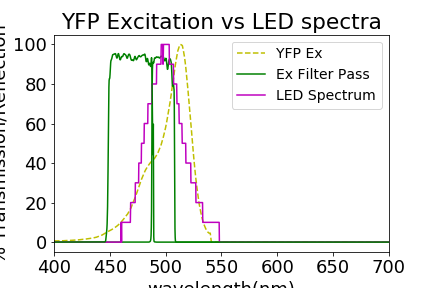
Fluorostat Construction/spetra/Figures/YFP_LED.png
