dschnitkey/Fluorostat_Codes/Fluorostat Construction/spetra/Figures/YFPCFP_Emission.png

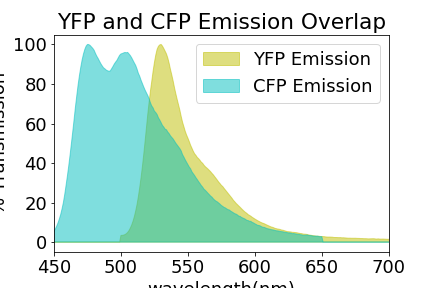
Fluorostat Construction/spetra/Figures/YFPCFP_Emission.png
