dschnitkey/Fluorostat_Codes/Fluorostat Construction/ringlight_calibration.xlsx

0 | 10 | 20 | 30 | 40 | 50 | 60 | 70 | 80 | 90 | 100 | 60 traj
0.1290893555 | 25.68878174 | 1424.501038 | 2174.122925 | 3313.723755 | 4395.492554 | 5571.496582 | 6273.449707 | 7246.713867 | 8173.07373 | 9143.406372 | 4716.813354
0.1290893555 | 25.68878174 | 1424.501038 | 2172.057495 | 3315.918274 | 4395.492554 | 5569.302063 | 6273.449707 | 7246.713867 | 8173.07373 | 9143.406372 | 4716.813354
0.1290893555 | 25.68878174 | 1422.306519 | 2174.122925 | 3313.723755 | 4395.492554 | 5573.562012 | 6273.449707 | 7246.713867 | 8173.07373 | 9143.406372 | 4716.813354
0.1290893555 | 25.68878174 | 1424.501038 | 2174.122925 | 3315.918274 | 4399.752502 | 5571.496582 | 6273.449707 | 7246.713867 | 8173.07373 | 9143.406372 | 4716.813354
0.1290893555 | 25.68878174 | 1424.501038 | 2176.317444 | 3315.918274 | 4393.298035 | 5569.302063 | 6273.449707 | 7246.713867 | 8173.07373 | 9143.406372 | 4716.813354
0.1290893555 | 25.68878174 | 1424.501038 | 2174.122925 | 3315.918274 | 4397.687073 | 5569.302063 | 6273.449707 | 7246.713867 | 8173.07373 | 9143.406372 | 4716.813354
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
