dschnitkey/Fluorostat_Codes/Fluorostat Construction/Optics:Mounts Cad/ER025-AutoCADPDF.pdf

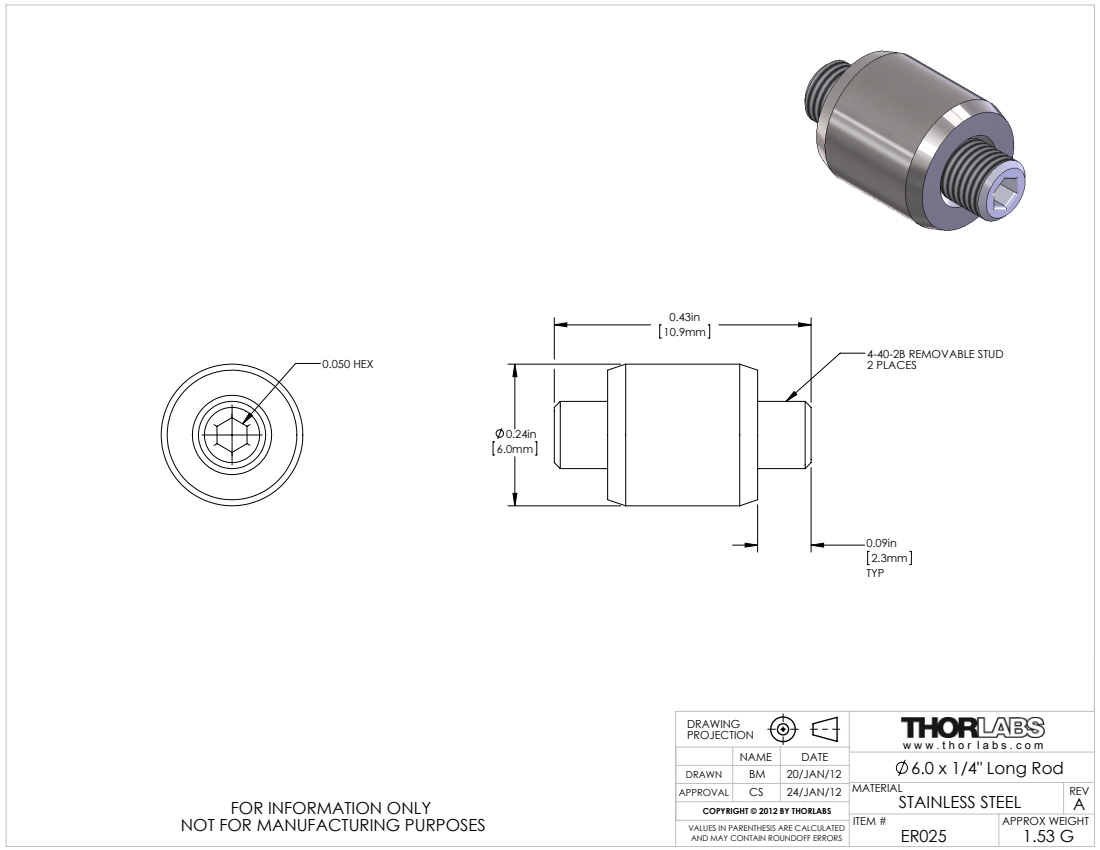
[picture p81: page 1]
4-40-2B REMOVABLE STUD; 0.050 HEX; 2 PLACES; ITEM #; APPROX WEIGHT; 6.0 x 1/4" Long Rod

DRAWING PROJECTION | | w w w . t h o r l a b s . c o m

NAME | DATE
APPROVAL | CS | 24/JAN/12 | MATERIAL STAINLESS STEEL | REV A

DRAWN | BM | 20/JAN/12

FOR INFORMATION ONLY
NOT FOR MANUFACTURING PURPOSES

COPYRIGHT © 2012 BY THORLABS
1.53 G VALUES IN PARENTHESIS ARE CALCULATED
AND MAY CONTAIN ROUNDOFF ERRORS
