dschnitkey/Fluorostat_Codes/Fluorostat Construction/Optics:Mounts Cad/SM1RRC-AutoCADPDF.pdf

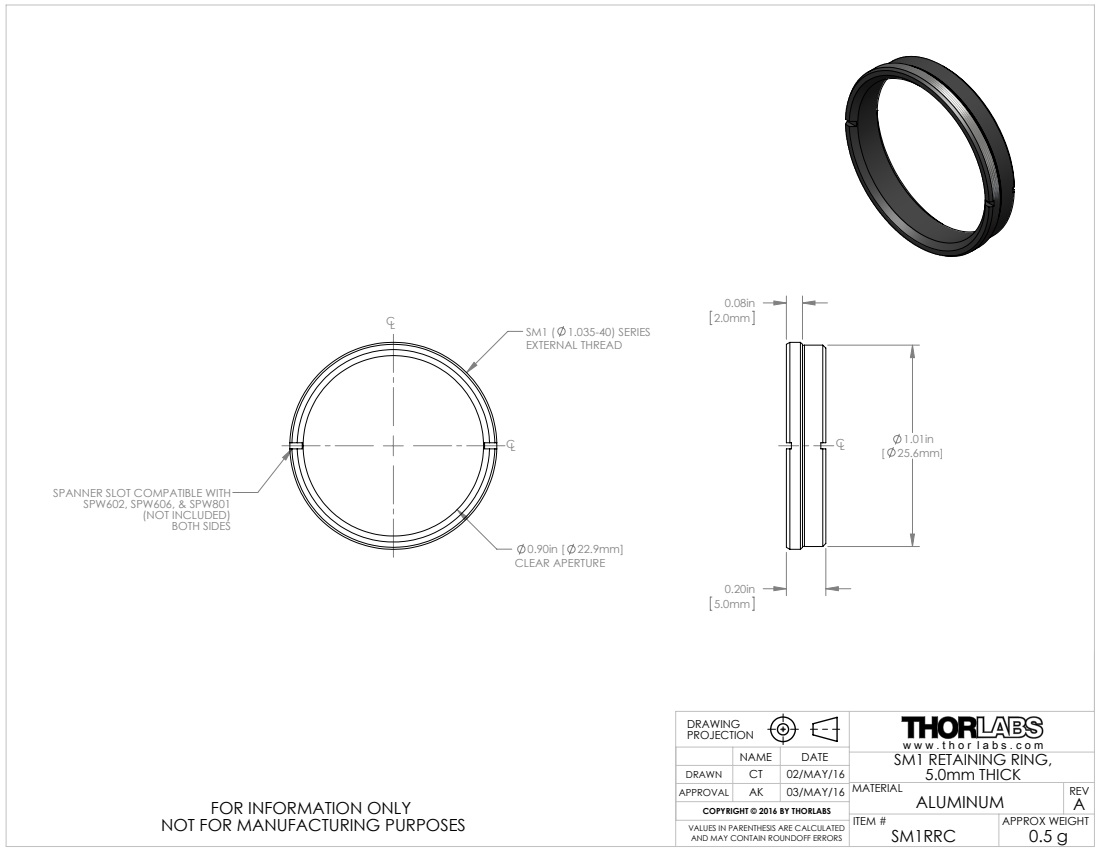
[picture p83: page 1]
SM1 ( 1.035-40) SERIES EXTERNAL THREAD; 0.90in [ 22.9mm] CLEAR APERTURE; (NOT INCLUDED) BOTH SIDES; ITEM #; APPROX WEIGHT; NAME; SM1 RETAINING RING,; 5.0mm THICK; FOR INFORMATION ONLY; COPYRIGHT © 2016 BY THORLABS

SPANNER SLOT COMPATIBLE WITH
SPW602, SPW606, & SPW801

DRAWN | CT | 02/MAY/16
APPROVAL | AK | 03/MAY/16 | MATERIAL ALUMINUM | REV A

NOT FOR MANUFACTURING PURPOSES

0.5 g VALUES IN PARENTHESIS ARE CALCULATED
AND MAY CONTAIN ROUNDOFF ERRORS
