dschnitkey/Fluorostat_Codes/Fluorostat Construction/Optics:Mounts Cad/SM1T2-AutoCADPDF.pdf

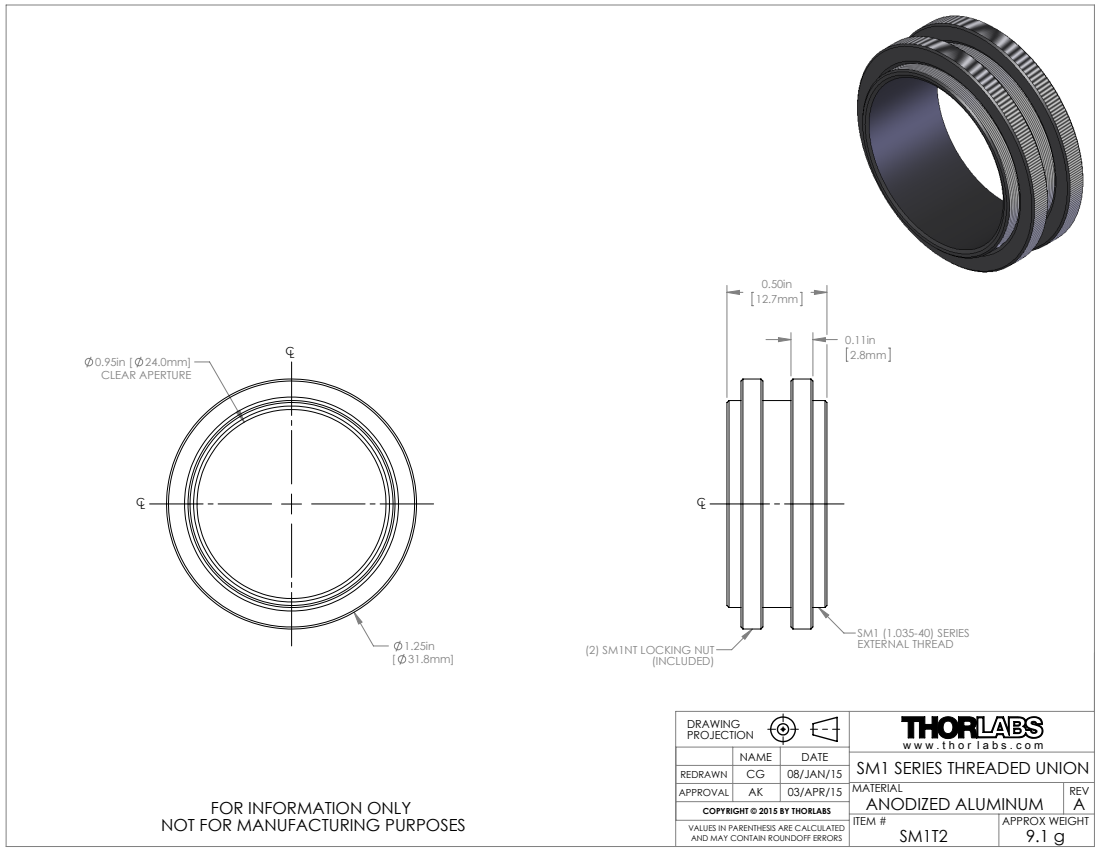
[picture p84: page 1]
(2) SM1NT LOCKING NUT; SM1 (1.035-40) SERIES EXTERNAL THREAD; 0.95in [ 24.0mm] CLEAR APERTURE; ITEM #; APPROX WEIGHT; FOR INFORMATION ONLY; COPYRIGHT © 2015 BY THORLABS

DRAWING PROJECTION | | w w w . t h o r l a b s . c o m

NAME | DATE
APPROVAL | AK | 03/APR/15 | MATERIAL ANODIZED ALUMINUM | REV A

SM1 SERIES THREADED UNION

REDRAWN | CG | 08/JAN/15

NOT FOR MANUFACTURING PURPOSES

9.1 g VALUES IN PARENTHESIS ARE CALCULATED
AND MAY CONTAIN ROUNDOFF ERRORS
