dschnitkey/Fluorostat_Codes/Fluorostat Construction/Machined Parts/CAD Drawings/Schematics/OD_holder.pdf

0 10.5

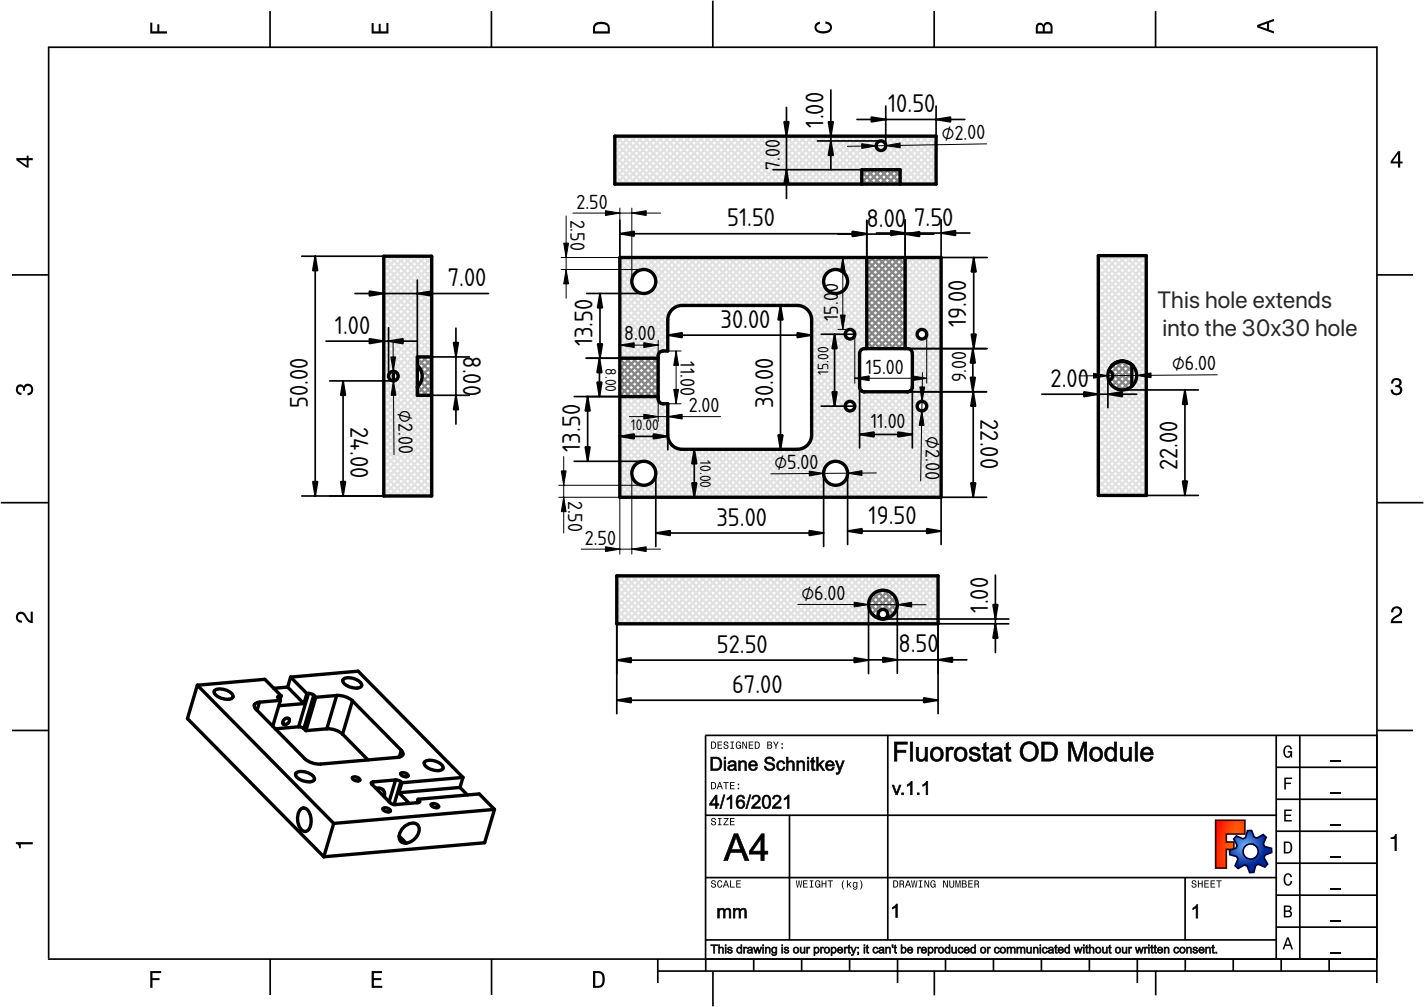
[picture p85: page 1]
his; ole; xte

s into the 30x30 hole
