dschnitkey/Fluorostat_Codes/Fluorostat Construction/Fluorostat PCB Plans/Fluorestat_motherboard_pcb.pdf

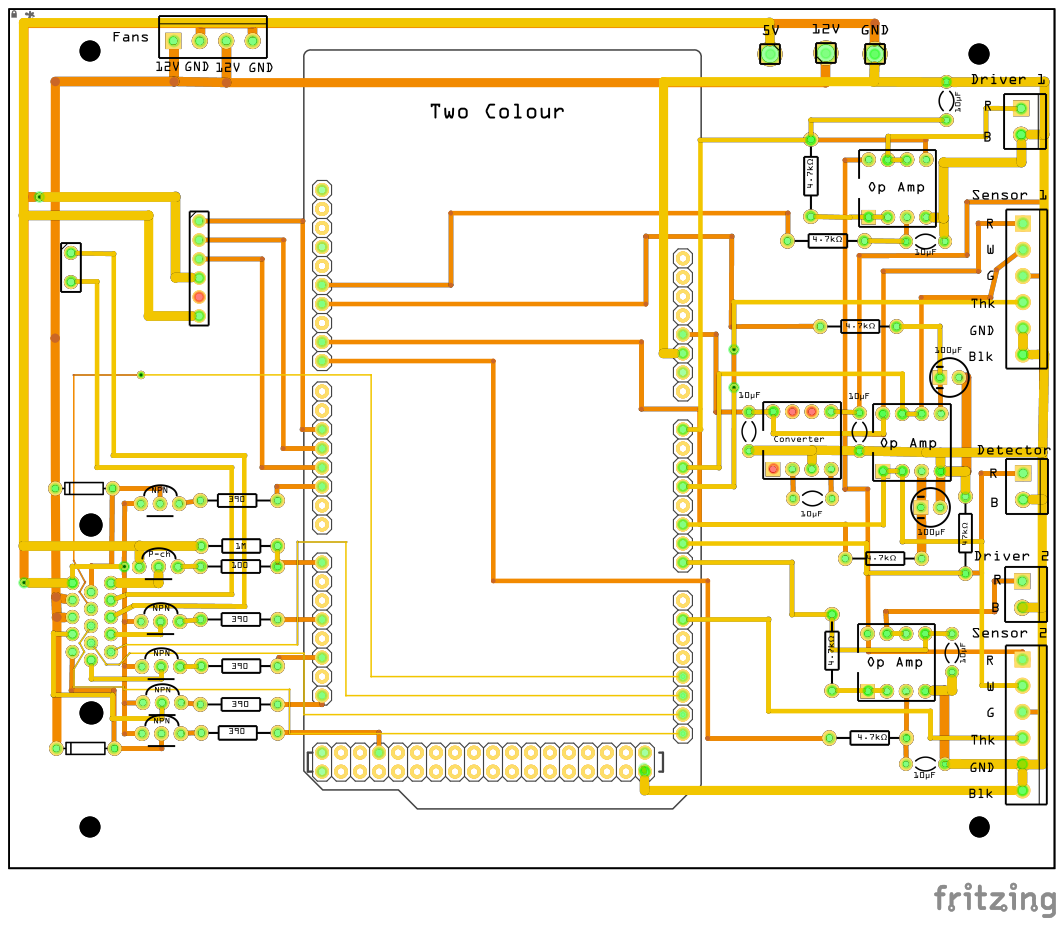
[picture p86: page 1]
