dschnitkey/Fluorostat_Codes/Fluorostat Construction/Machined Parts/CAD Drawings/Schematics/motorholder_prethreading_schematicv2.pdf

### Dia

m

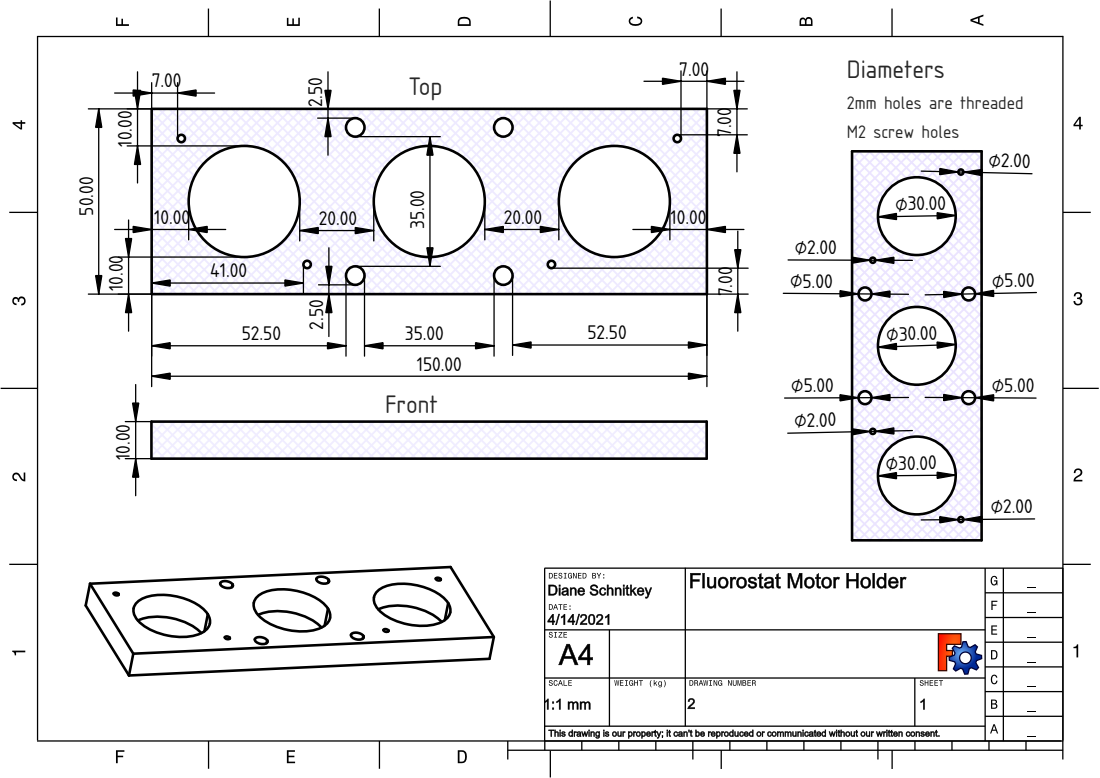
[picture p87: page 1]
Fro; nt Top; eters; ole; are thre; scre
