dschnitkey/Fluorostat_Codes/(list of files, drawings)

Other design files:
Fluorostat Construction/Fluorostat PCB Plans/Fluorestat_moterboard.fzz
Fluorostat Construction/Fluorostat PCB Plans/Fluorestat_moterboard_cyano.fzz
Fluorostat Construction/Fluorostat PCB Plans/Hub.fzz
Fluorostat Construction/Fluorostat PCB Plans/SSR.fzz
